Dhruv242003/GRF_Shoe/Images/System Design.png

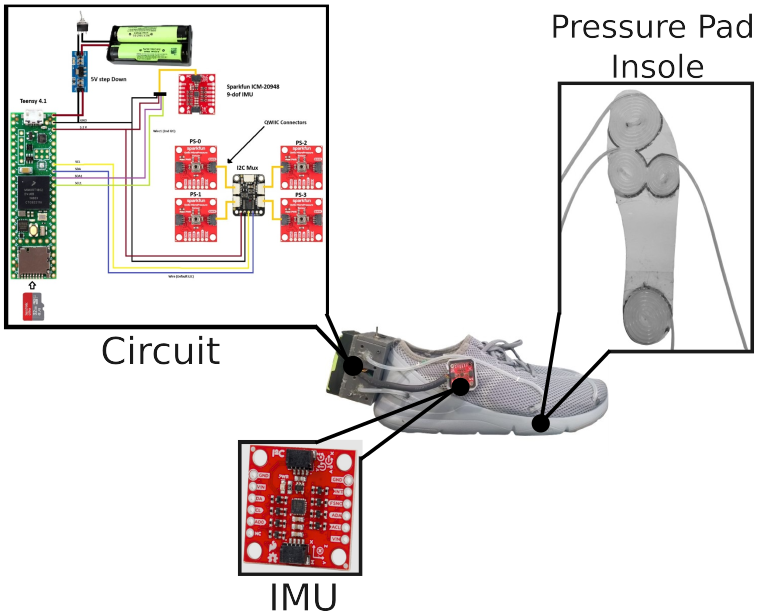
Images/System Design.png
