Dhruv242003/GRF_Shoe/Images/I2C_mux.jpg

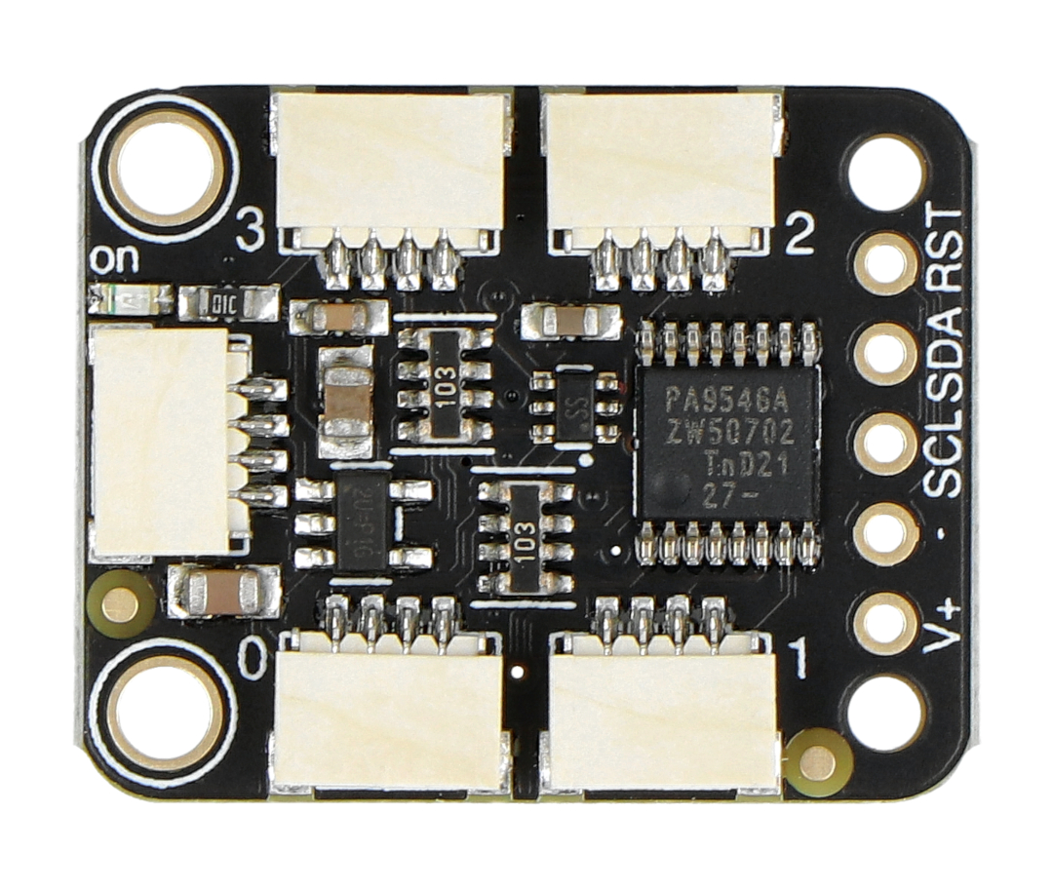
Images/I2C_mux.jpg
