Dhruv242003/GRF_Shoe/Presentation/Smart Shoes.pptx

## Smart Shoes

- HCR Lab Meeting

- Dhruv Thakkar

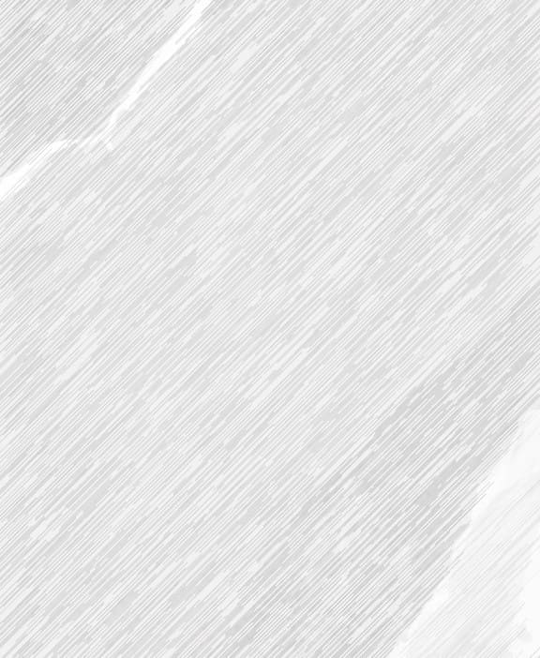
[picture p3: figure]
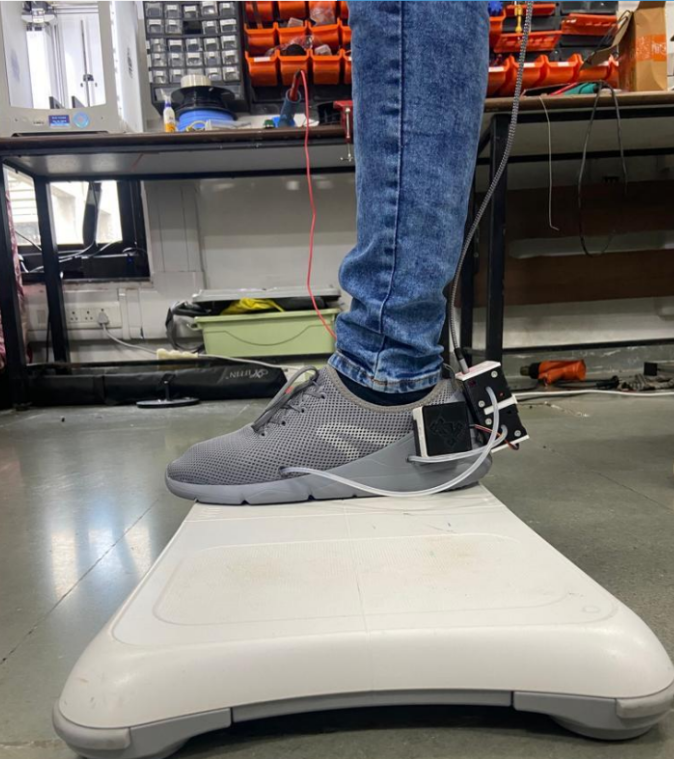
[picture p4: figure]

## Progress Till Now

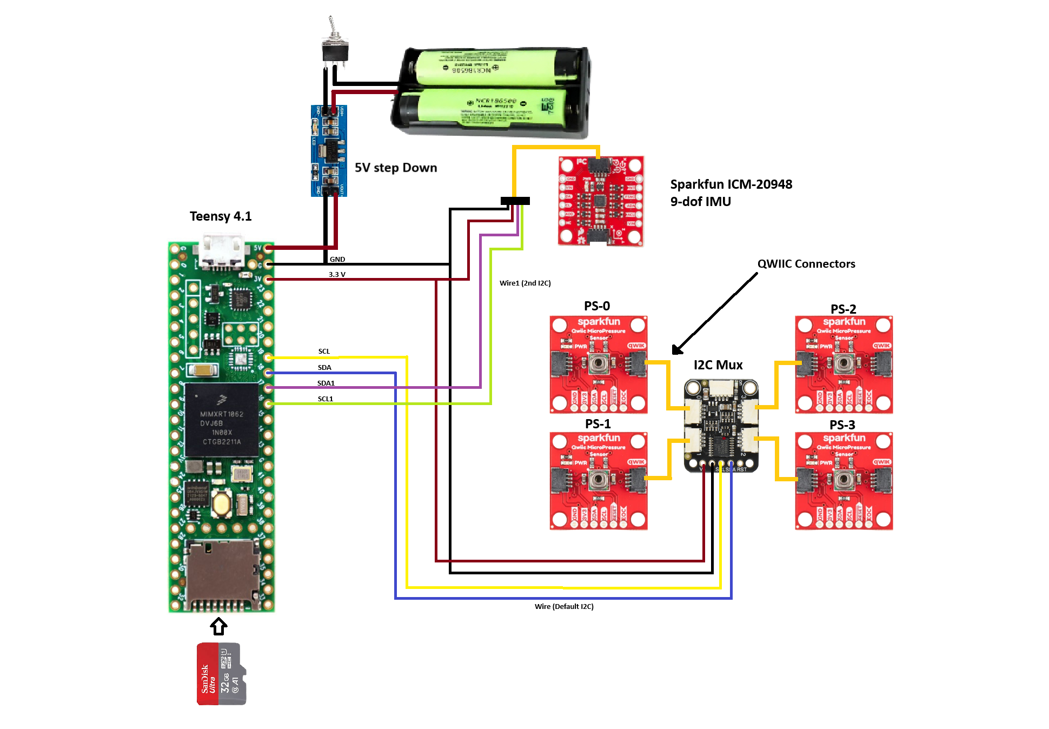
[picture p5: figure]

Circuit Diagram

## CAD

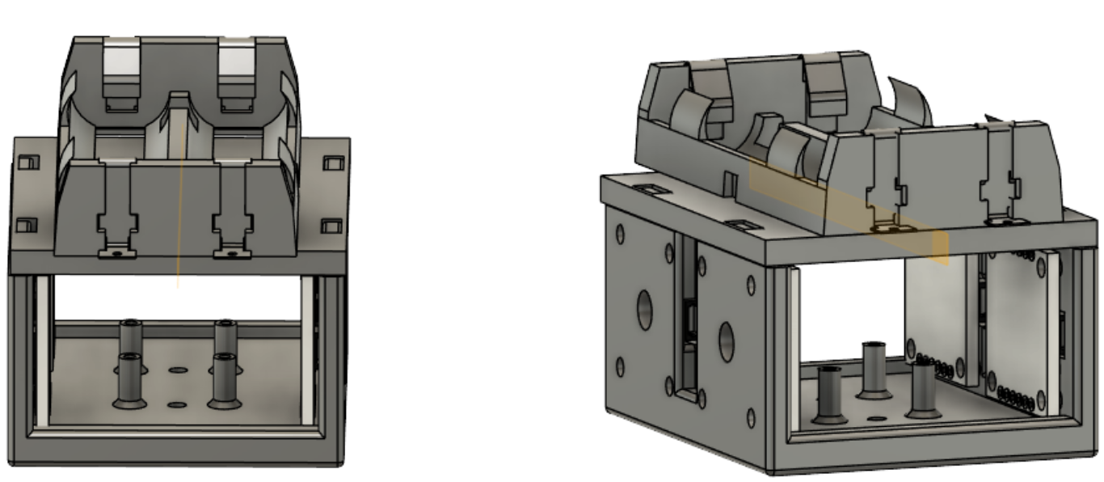
[picture p6: figure]

## Slide 4
