Dhruv242003/GRF_Shoe/Circuit/Dual_i2c.png

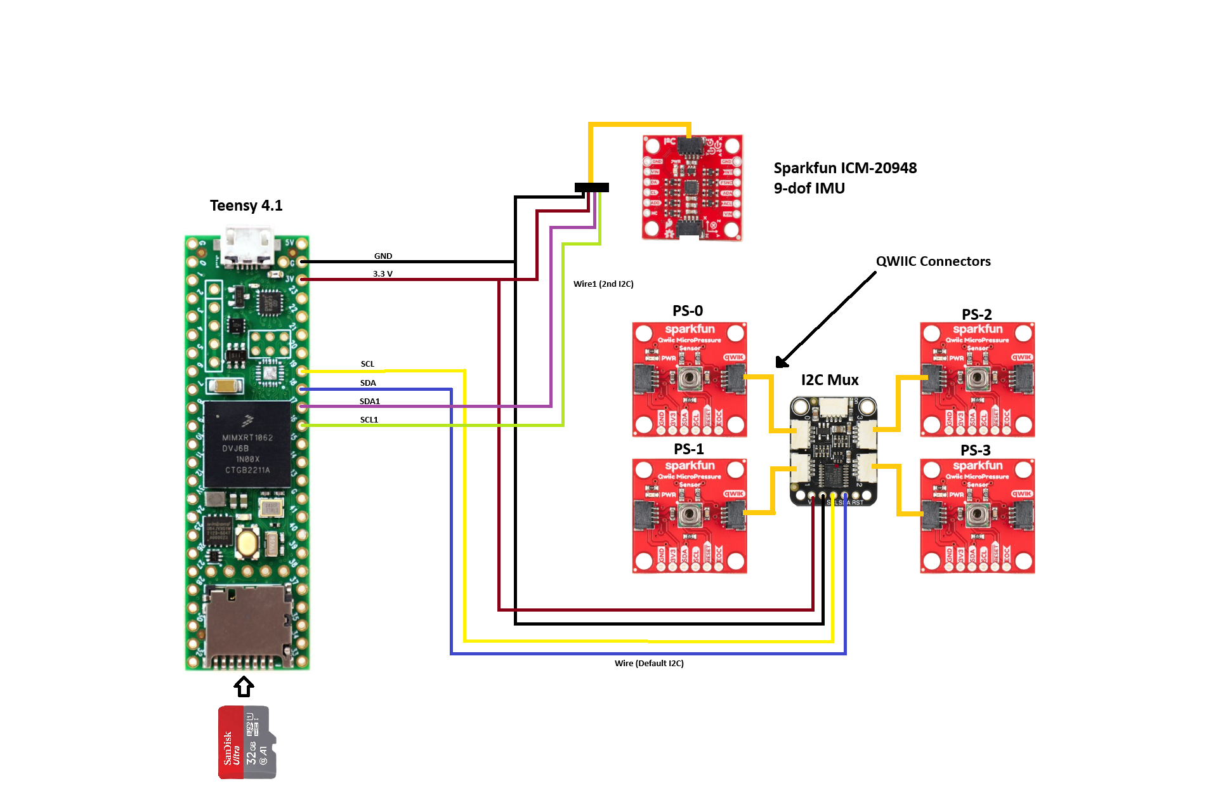
Circuit/Dual_i2c.png
