Dhruv242003/GRF_Shoe/Images/All_models_grid.png

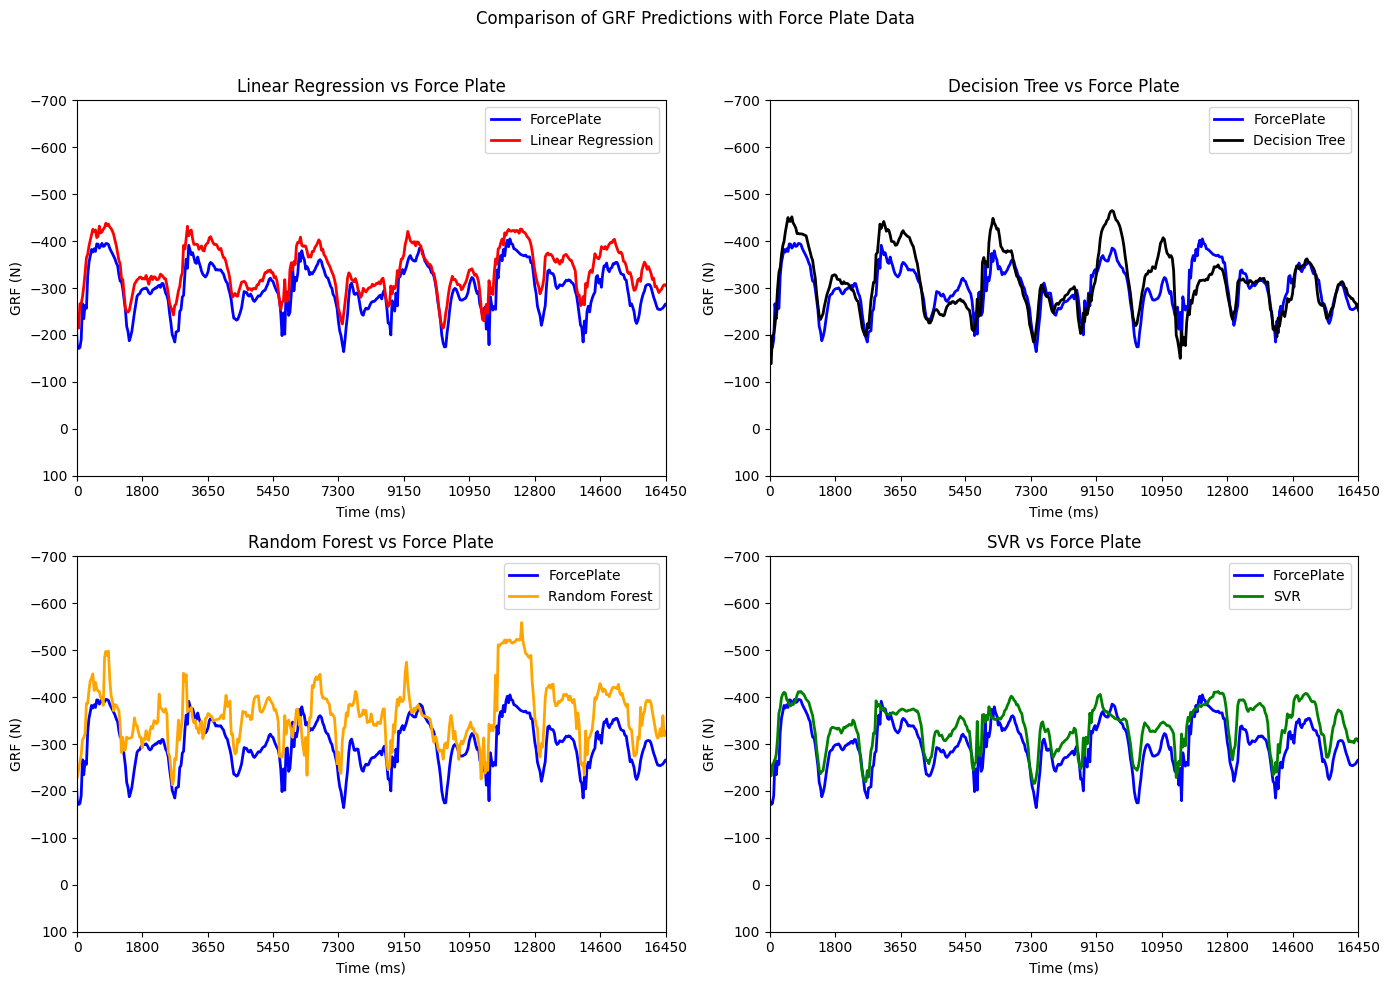
Images/All_models_grid.png
