Dhruv242003/GRF_Shoe/Images/All_models_plot.png

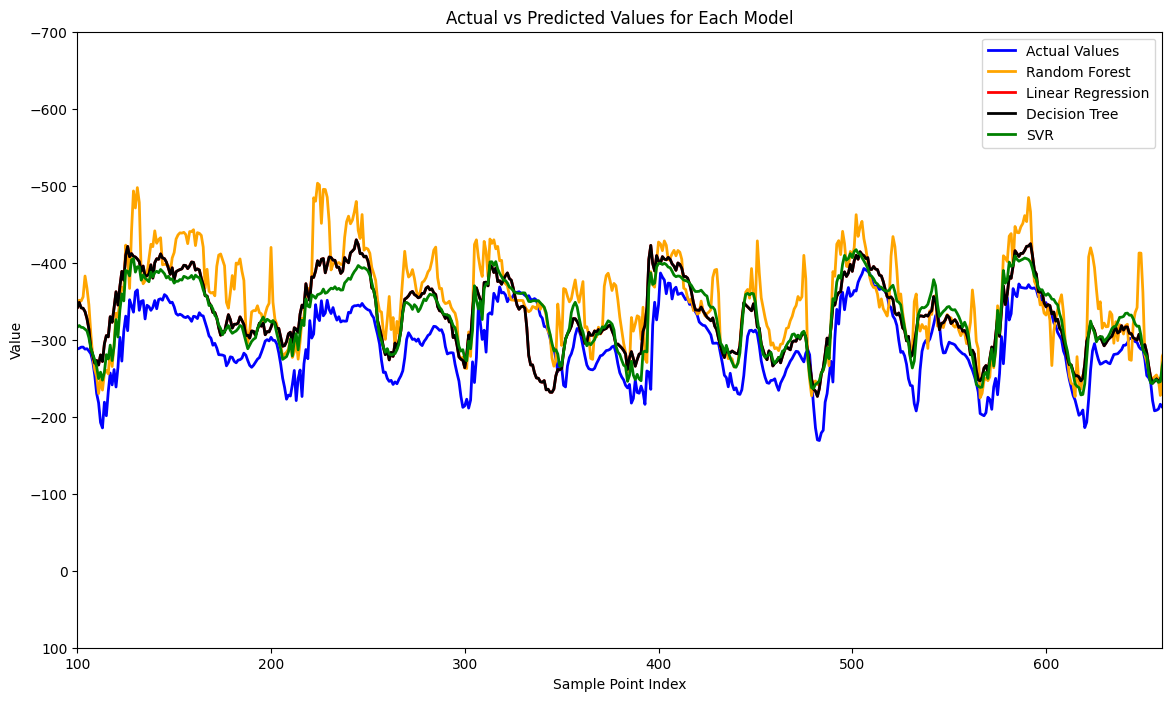
Images/All_models_plot.png
