Dhruv242003/GRF_Shoe/Images/DL_output.png

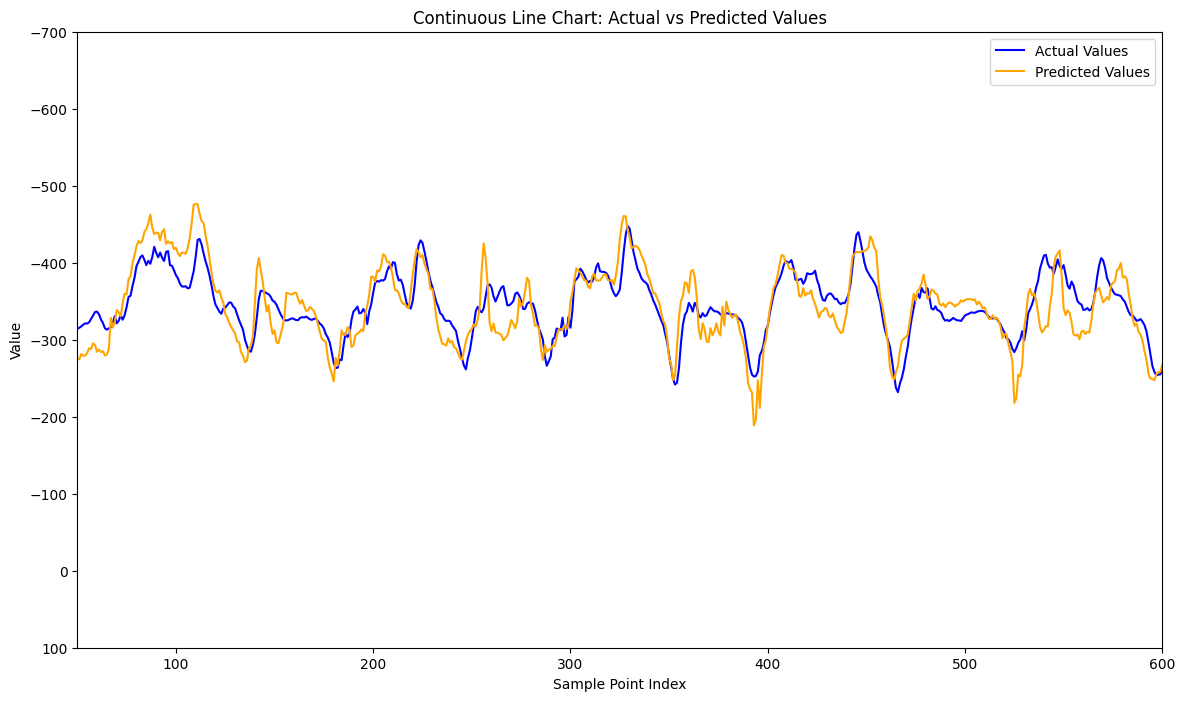
Images/DL_output.png
