Dhruv242003/GRF_Shoe/Images/download.png

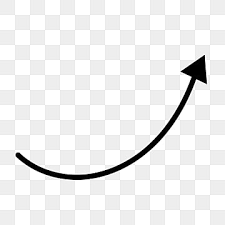
Images/download.png
