Dhruv242003/GRF_Shoe/Images/Flat_foot.jpg

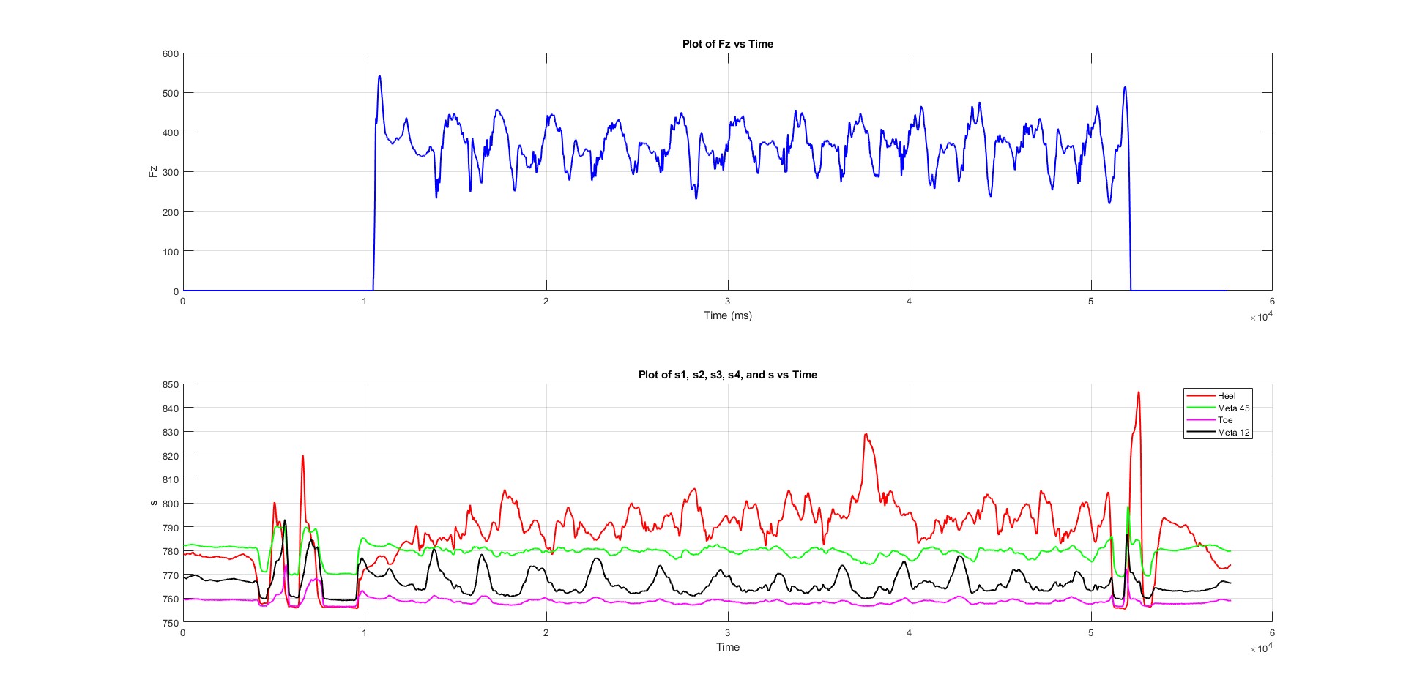
Images/Flat_foot.jpg
