Dhruv242003/GRF_Shoe/Images/Flowchart1.png

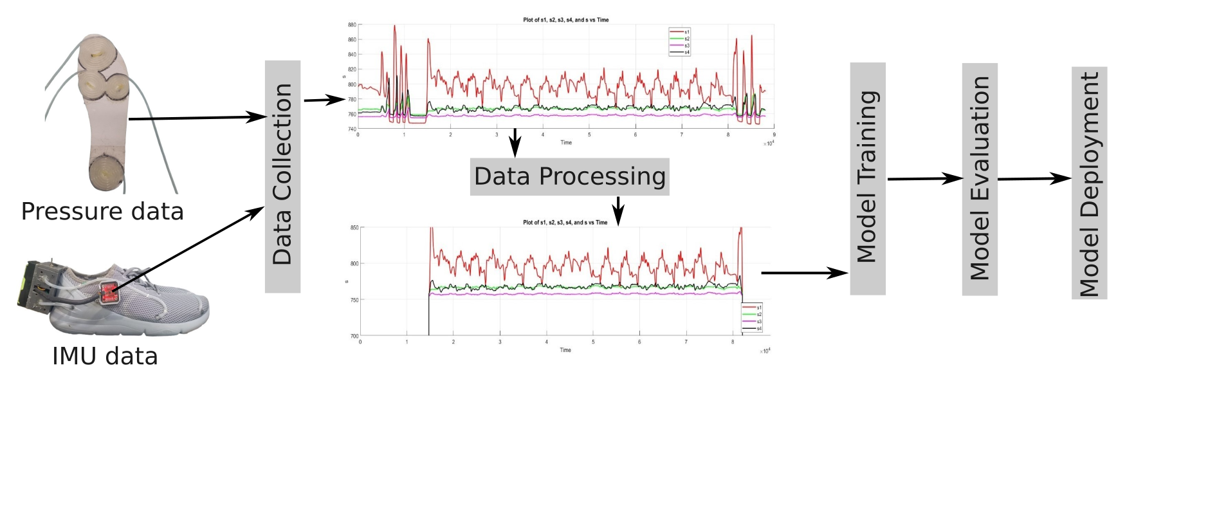
Images/Flowchart1.png
