Dhruv242003/GRF_Shoe/Images/LinearRegression_plot.png

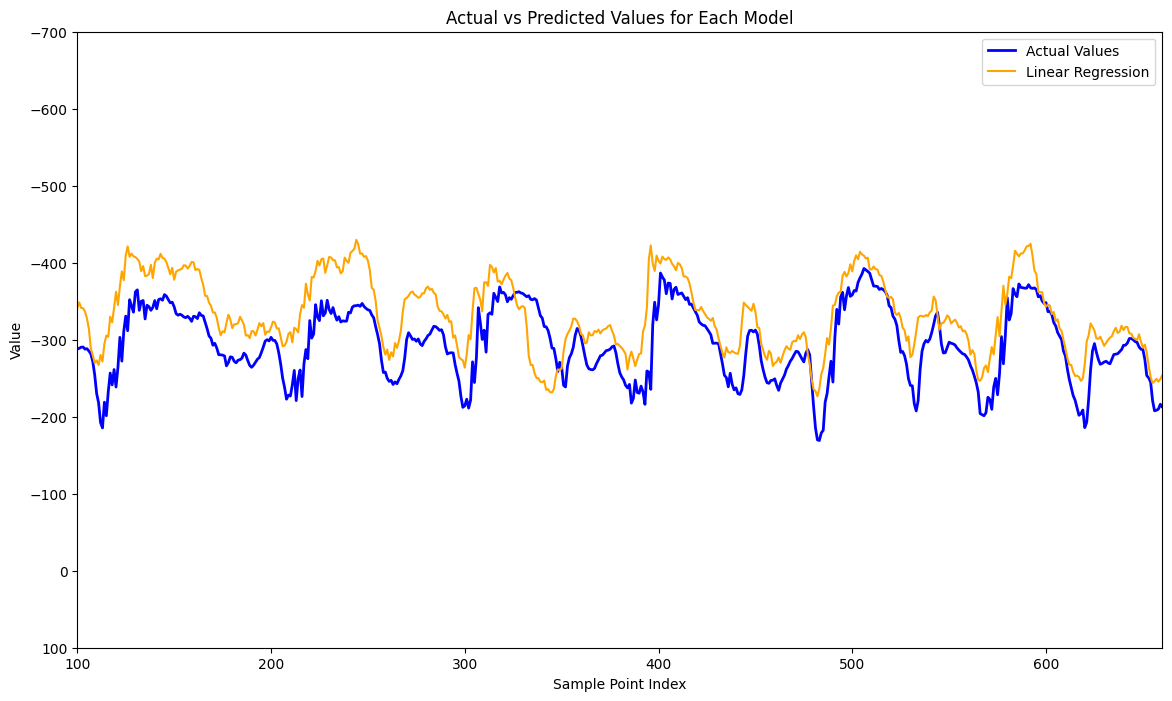
Images/LinearRegression_plot.png
