Dhruv242003/GRF_Shoe/Images/LossCurve.png

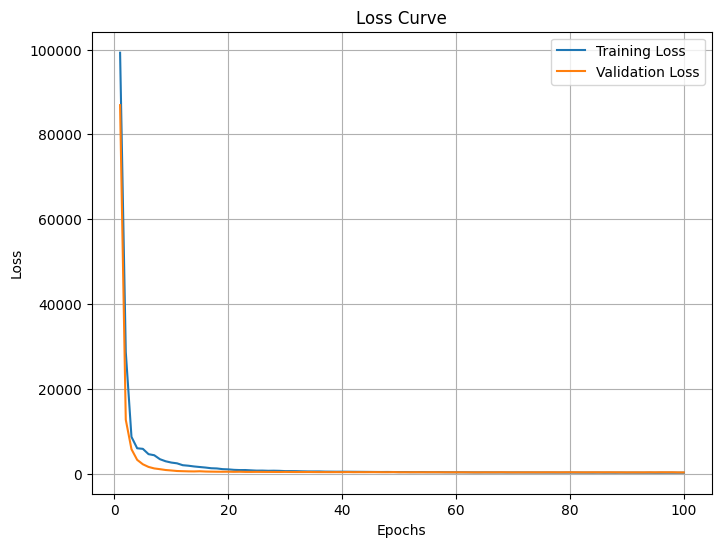
Images/LossCurve.png
