Dhruv242003/GRF_Shoe/Images/Model Architecture.png

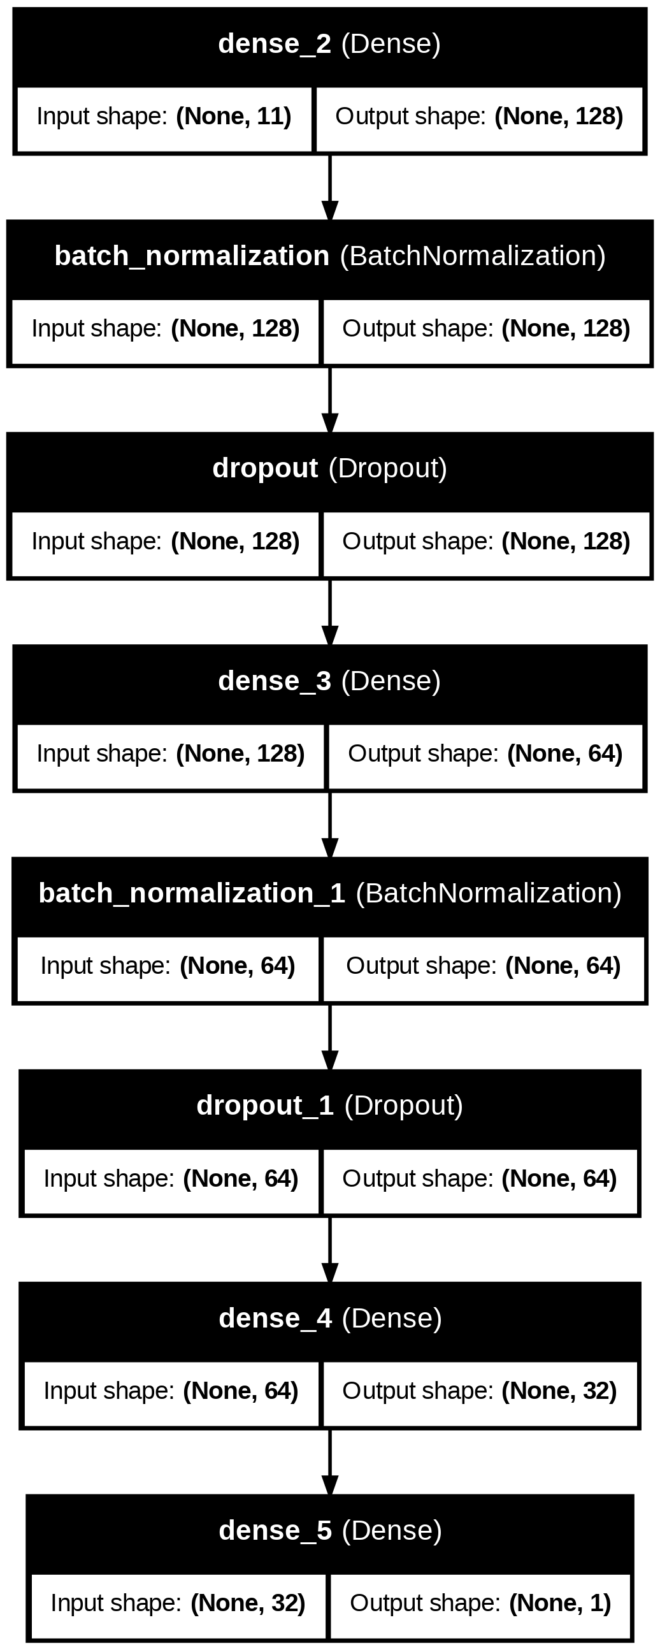
Images/Model Architecture.png
