Dhruv242003/GRF_Shoe/Images/Normal_foot.jpg

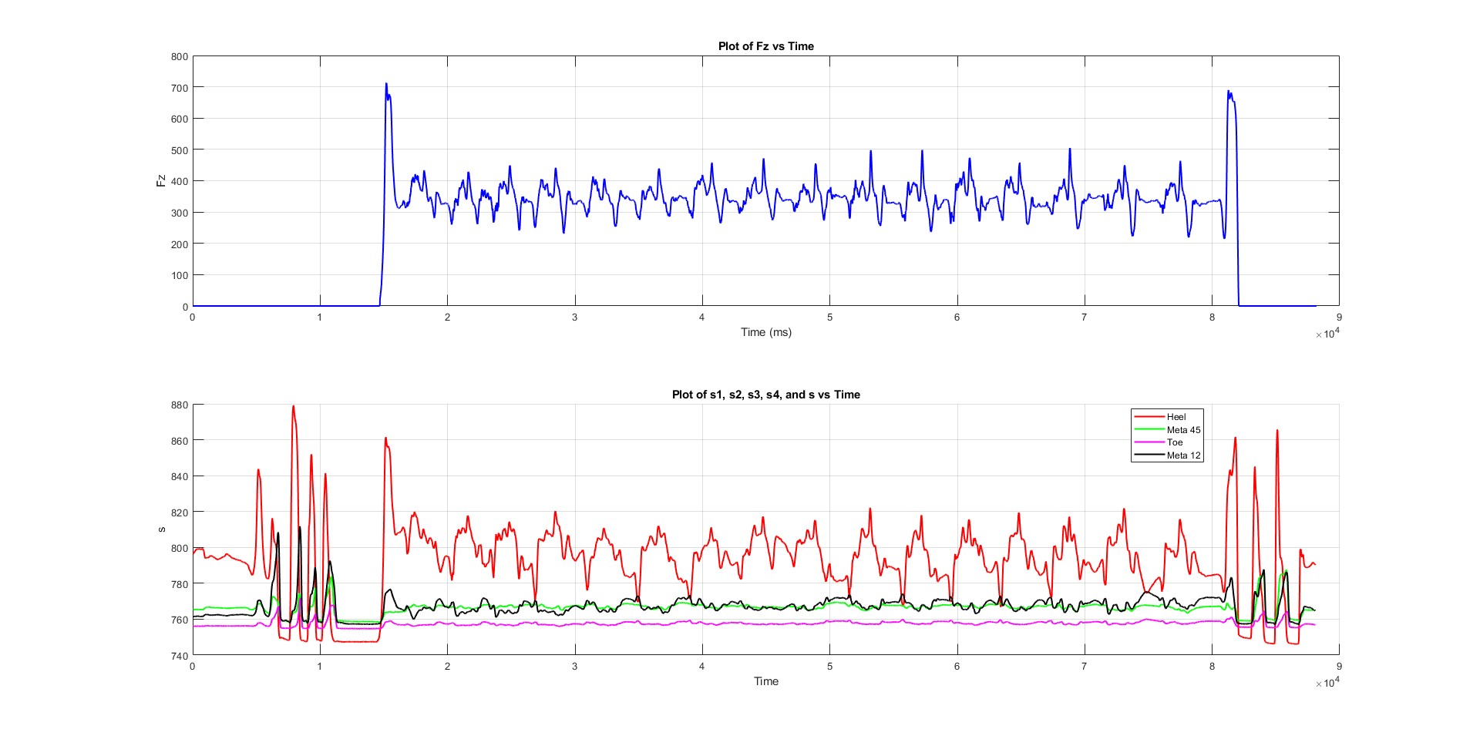
Images/Normal_foot.jpg
