Dhruv242003/GRF_Shoe/Images/oneSquat.png

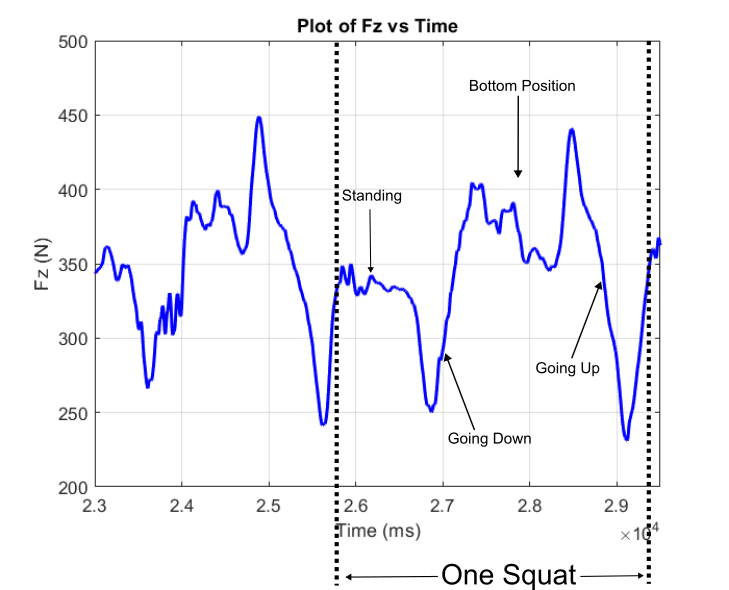
Images/oneSquat.png
