Dhruv242003/GRF_Shoe/Images/output.png

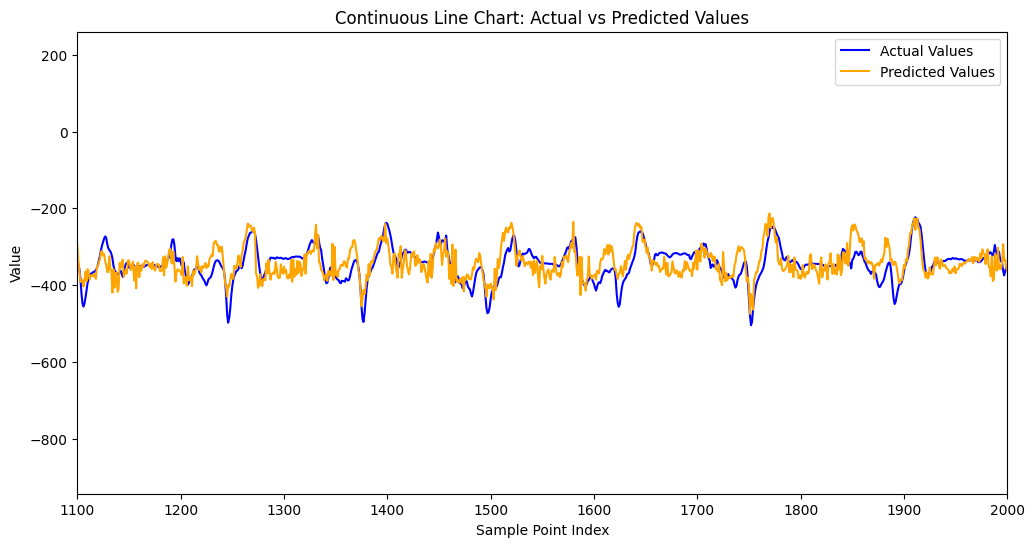
Images/output.png
