Dhruv242003/GRF_Shoe/Images/Pneumatic_connections.png

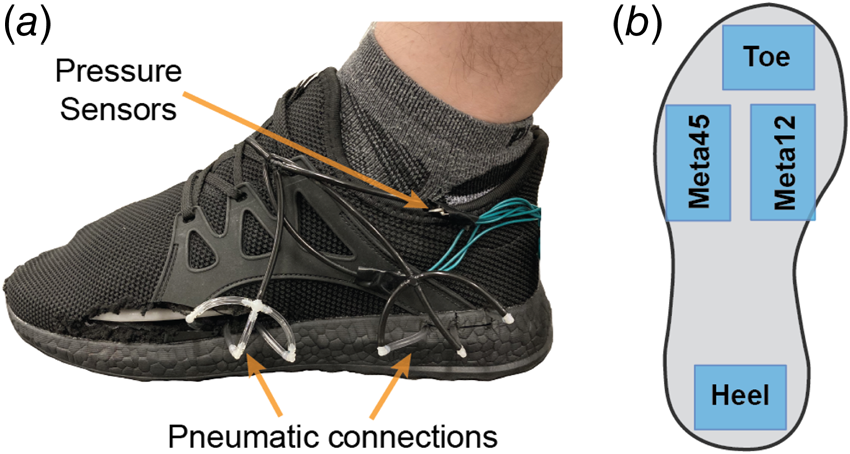
Images/Pneumatic_connections.png
