Dhruv242003/GRF_Shoe/Images/pressure_sensor-removebg-preview.png

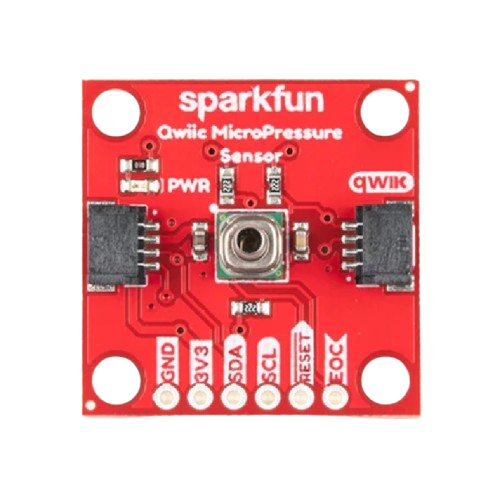
Images/pressure_sensor-removebg-preview.png
