Dhruv242003/GRF_Shoe/Images/Regression Output.png

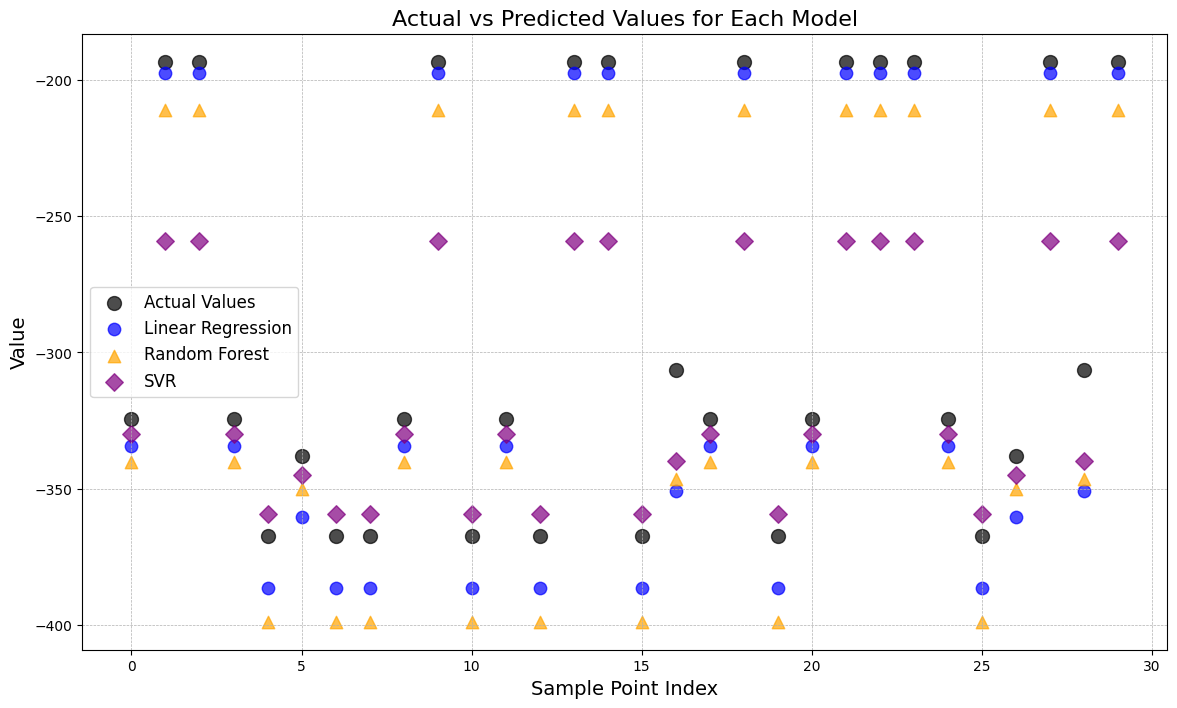
Images/Regression Output.png
