Dhruv242003/GRF_Shoe/Images/rt_LR.png

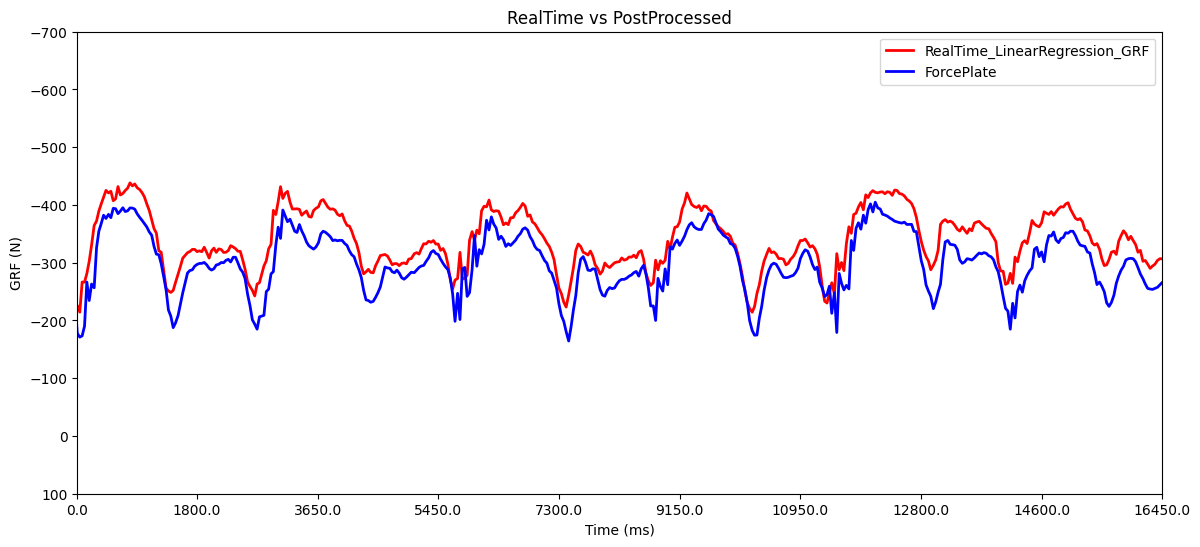
Images/rt_LR.png
