Dhruv242003/GRF_Shoe/Images/rt_vs_laptop_sameMaths.png

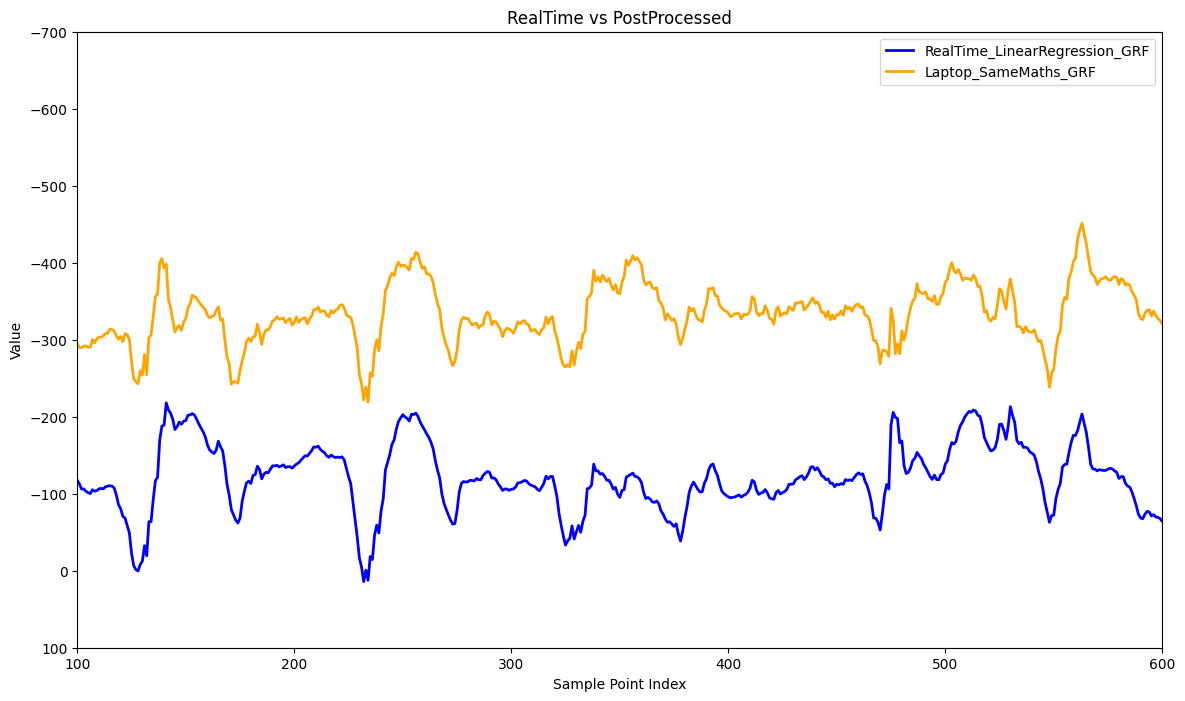
Images/rt_vs_laptop_sameMaths.png
