Dhruv242003/GRF_Shoe/Images/rt_vs_postProcessing.png

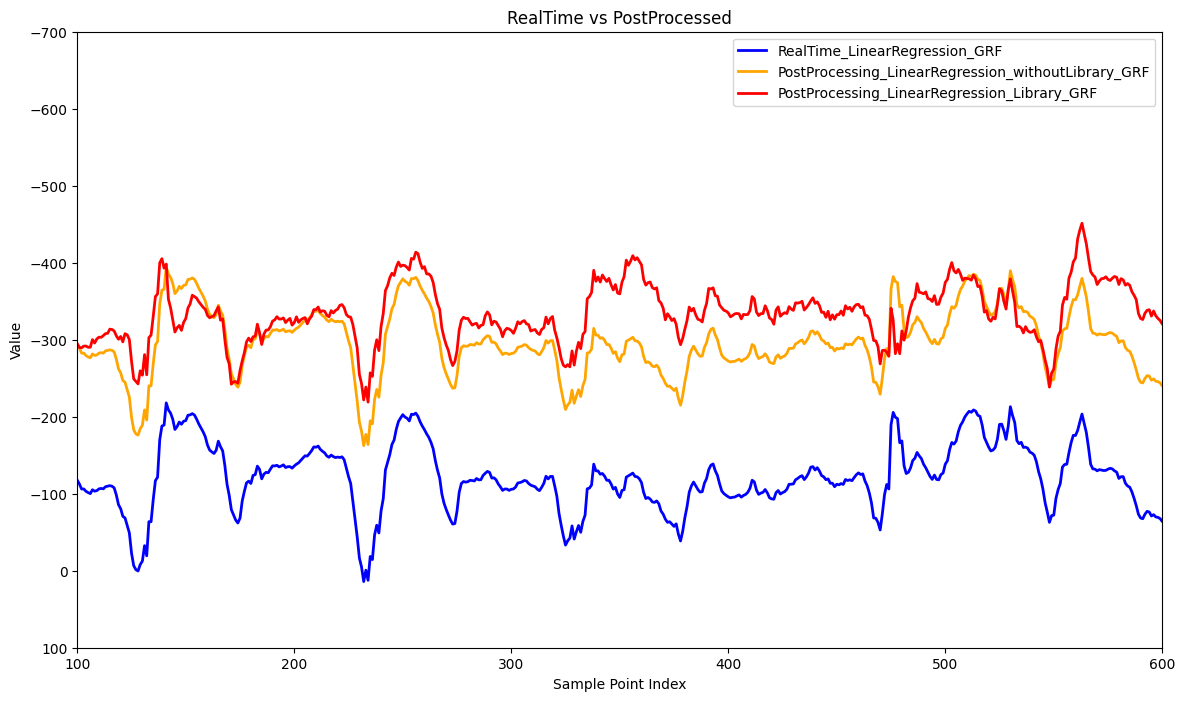
Images/rt_vs_postProcessing.png
