Dhruv242003/GRF_Shoe/Images/Screenshot 2024-08-16 115110.png

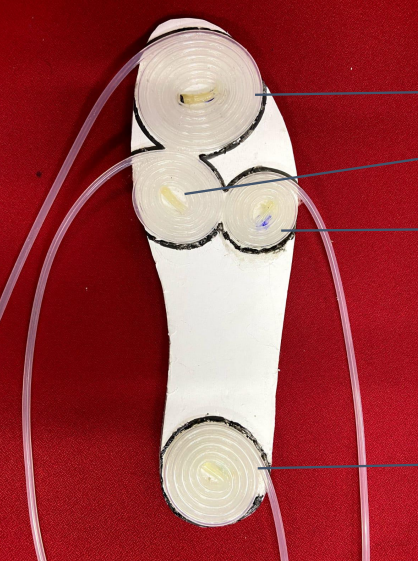
Images/Screenshot 2024-08-16 115110.png
