Dhruv242003/GRF_Shoe/Images/Screenshot 2024-09-20 162421.png

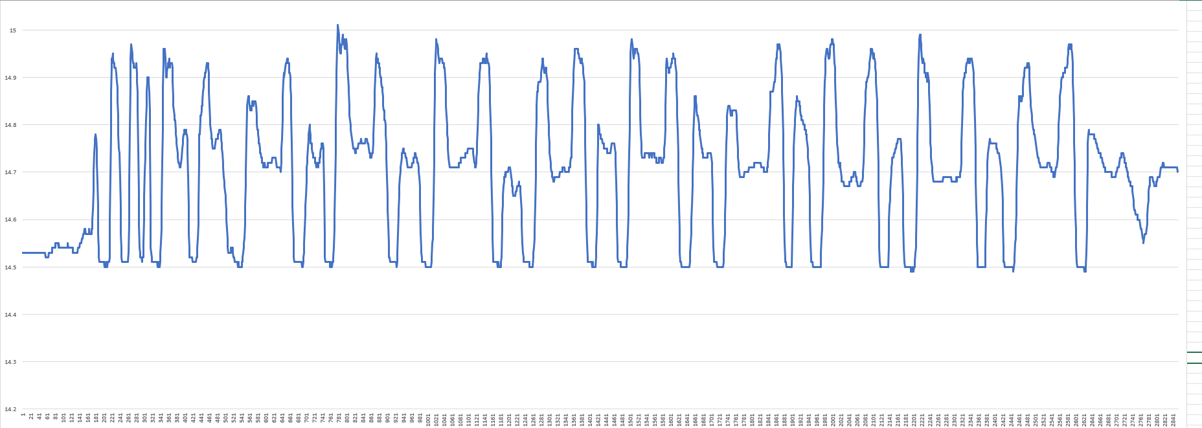
Images/Screenshot 2024-09-20 162421.png
