Dhruv242003/GRF_Shoe/Images/Screenshot 2024-10-01 151310.png

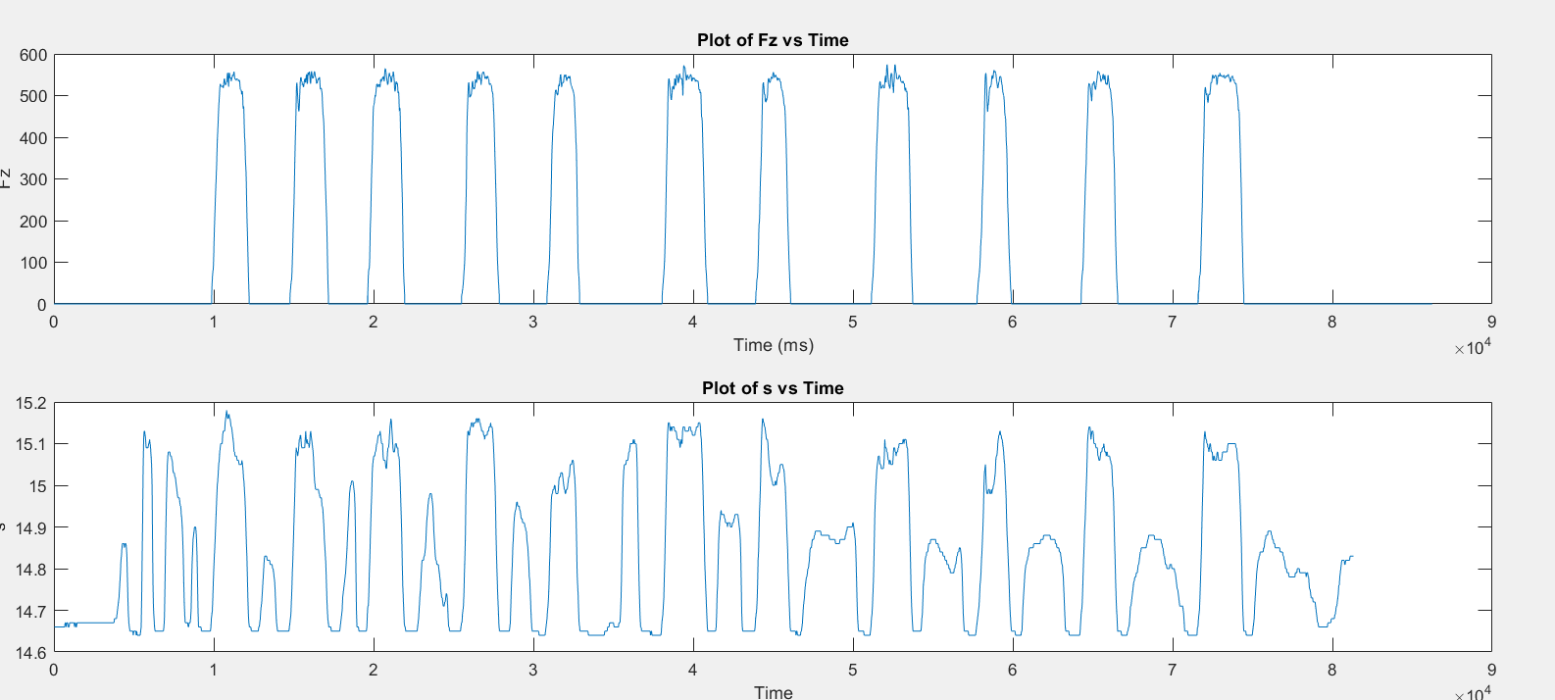
Images/Screenshot 2024-10-01 151310.png
