Dhruv242003/GRF_Shoe/Images/Screenshot 2024-10-01 161214.png

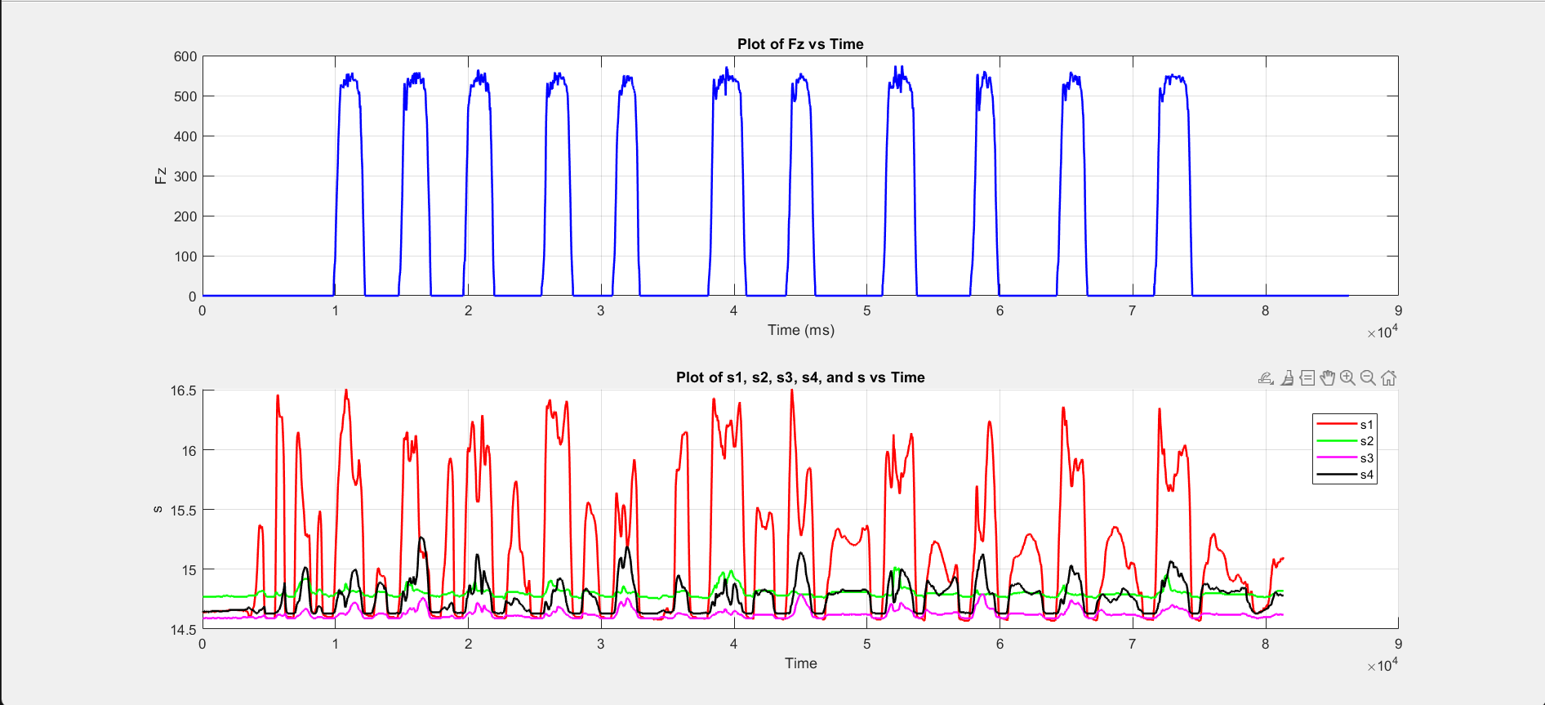
Images/Screenshot 2024-10-01 161214.png
