Dhruv242003/GRF_Shoe/Images/Screenshot 2024-10-01 162554.png

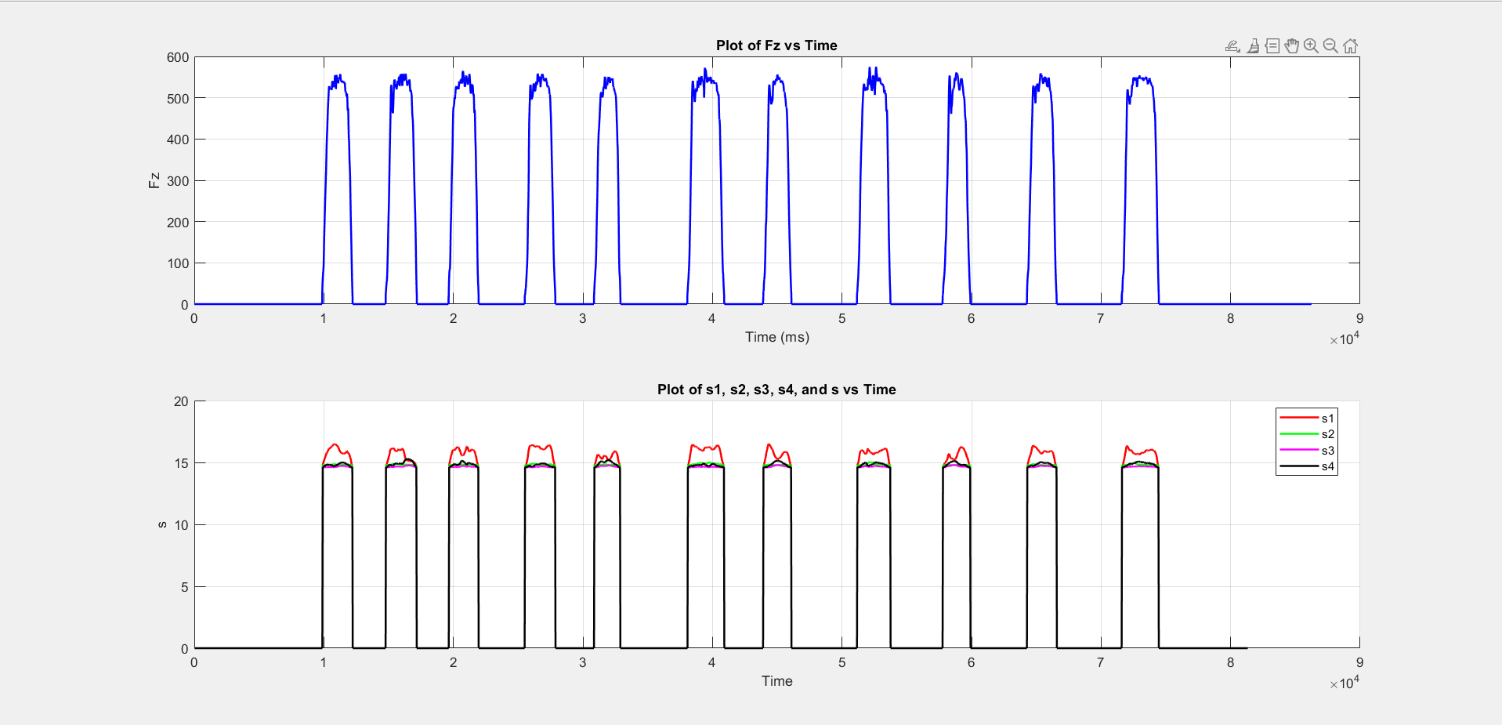
Images/Screenshot 2024-10-01 162554.png
