Dhruv242003/GRF_Shoe/Images/SD card.jpg

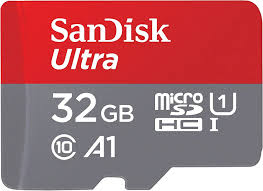
Images/SD card.jpg
