Dhruv242003/GRF_Shoe/Images/sitToStand_DL.png

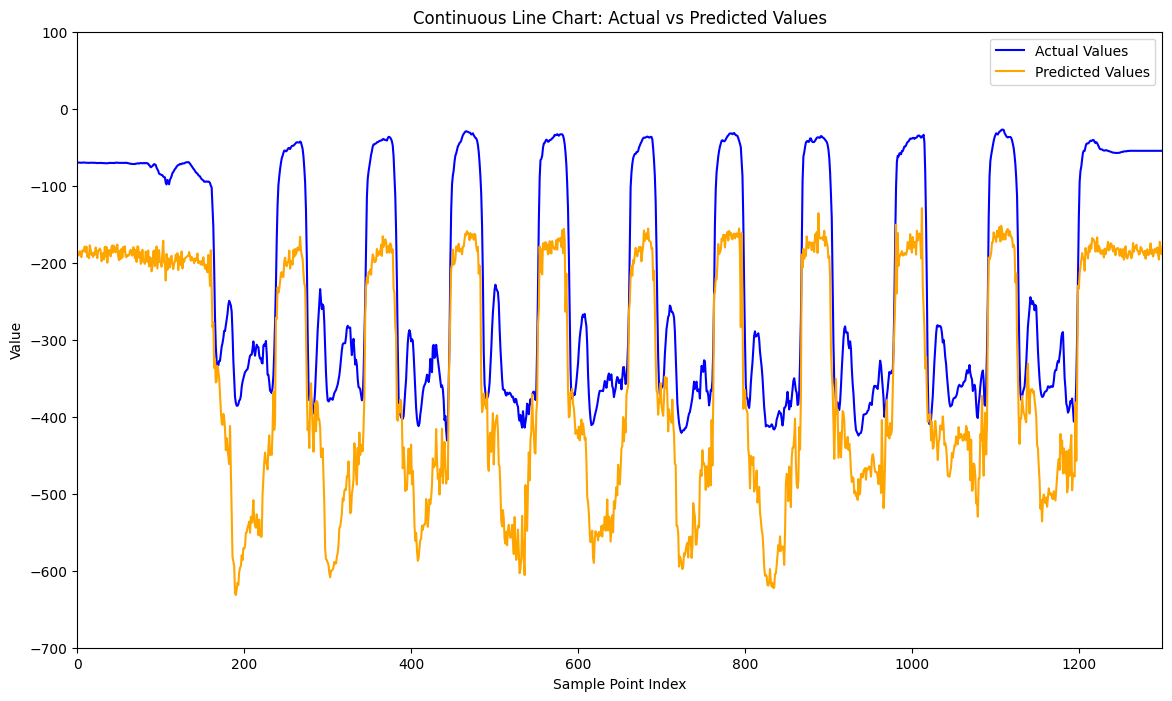
Images/sitToStand_DL.png
