Dhruv242003/GRF_Shoe/Images/sitToStand_randomForest.png

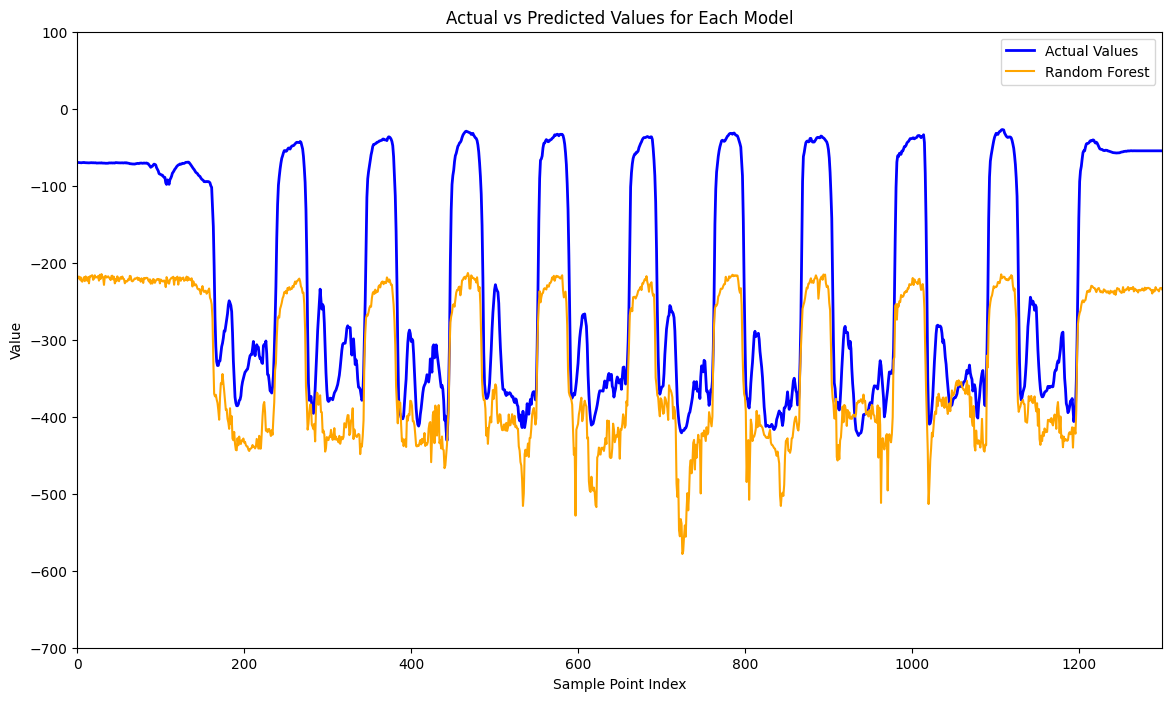
Images/sitToStand_randomForest.png
