Dhruv242003/GRF_Shoe/Images/sitToStand_twoShoes.jpg

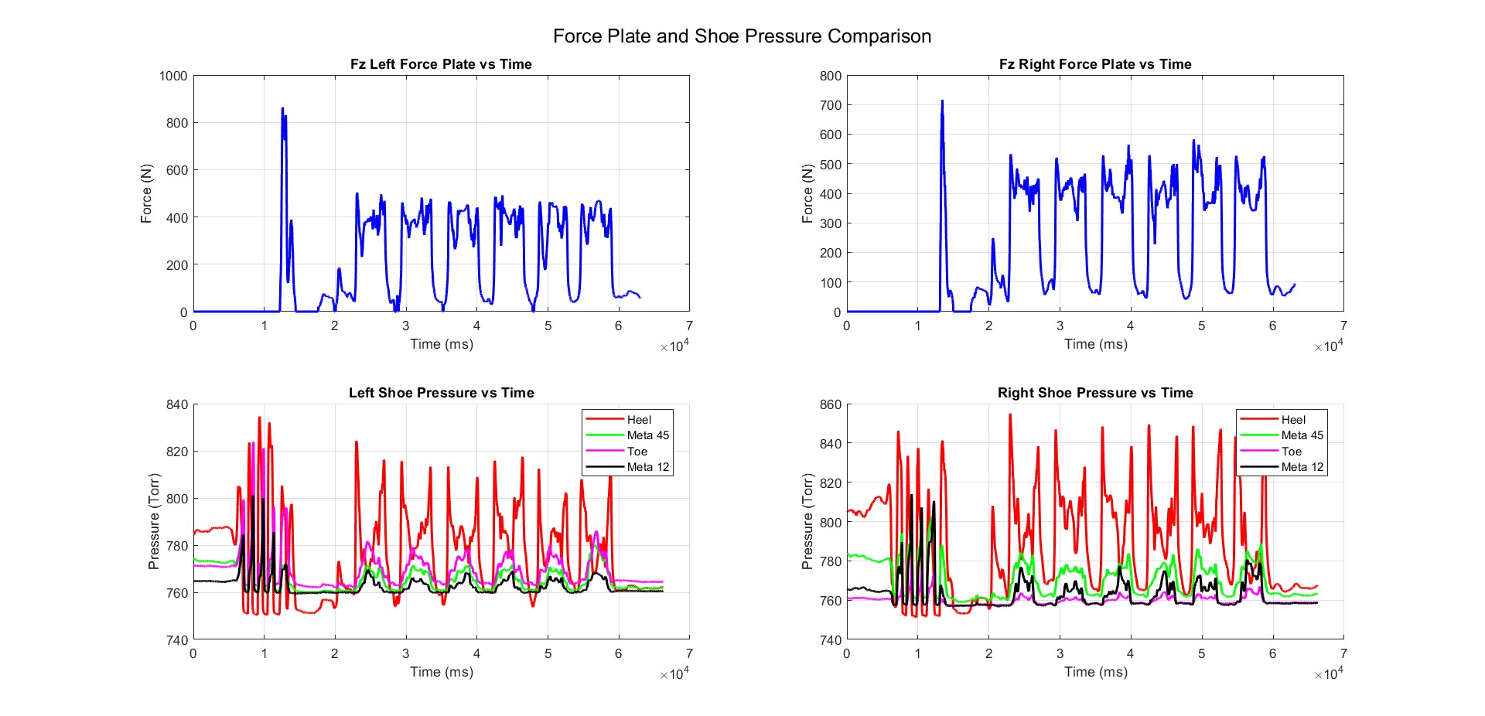
Images/sitToStand_twoShoes.jpg
