Dhruv242003/GRF_Shoe/Images/Sparkfun_ICM-20948-removebg-preview.png

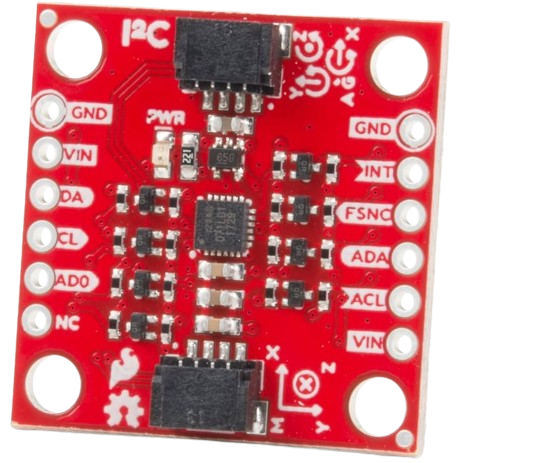
Images/Sparkfun_ICM-20948-removebg-preview.png
