Dhruv242003/GRF_Shoe/Images/sqautting_oneCycle.png

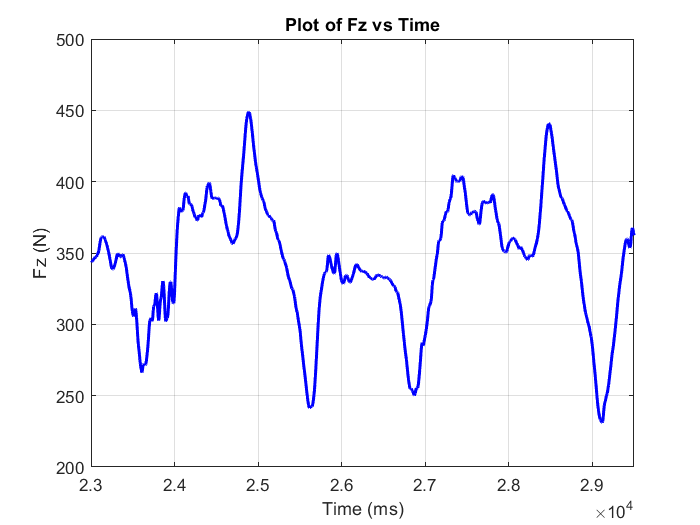
Images/sqautting_oneCycle.png
