Dhruv242003/GRF_Shoe/Images/squatting processed.jpg

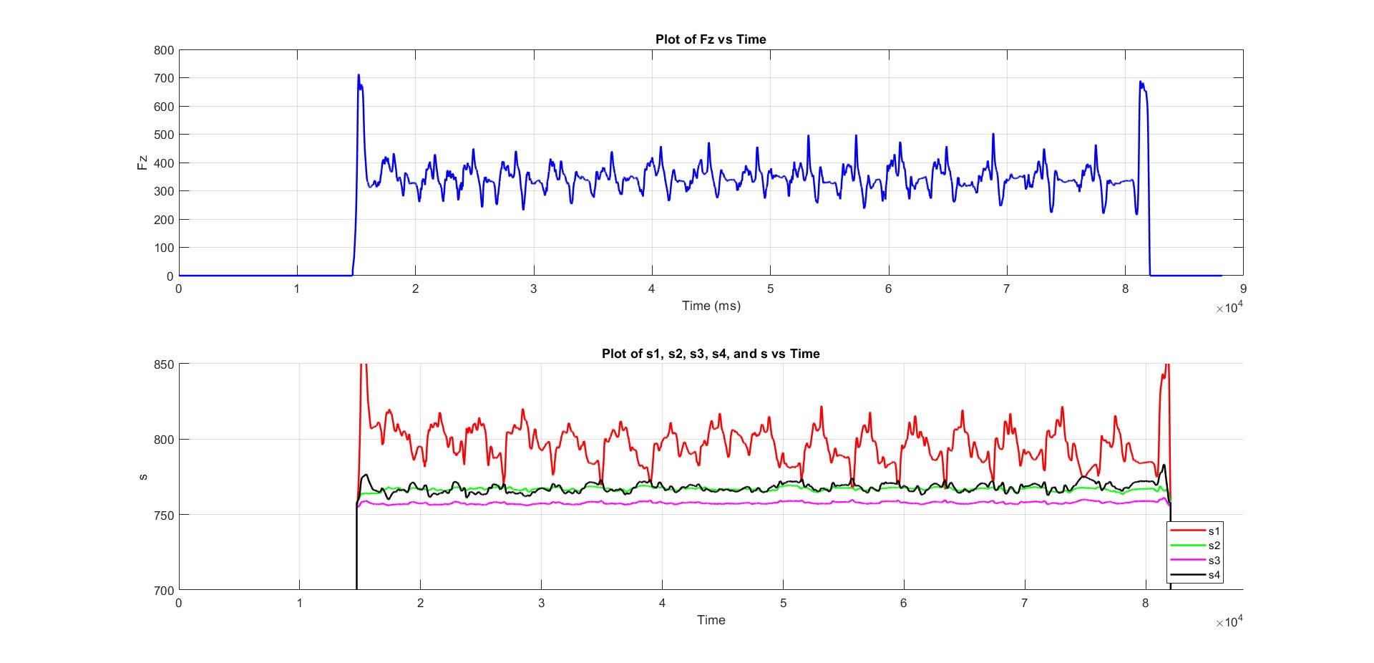
Images/squatting processed.jpg
