Dhruv242003/GRF_Shoe/Images/squatting uprocessed.jpg

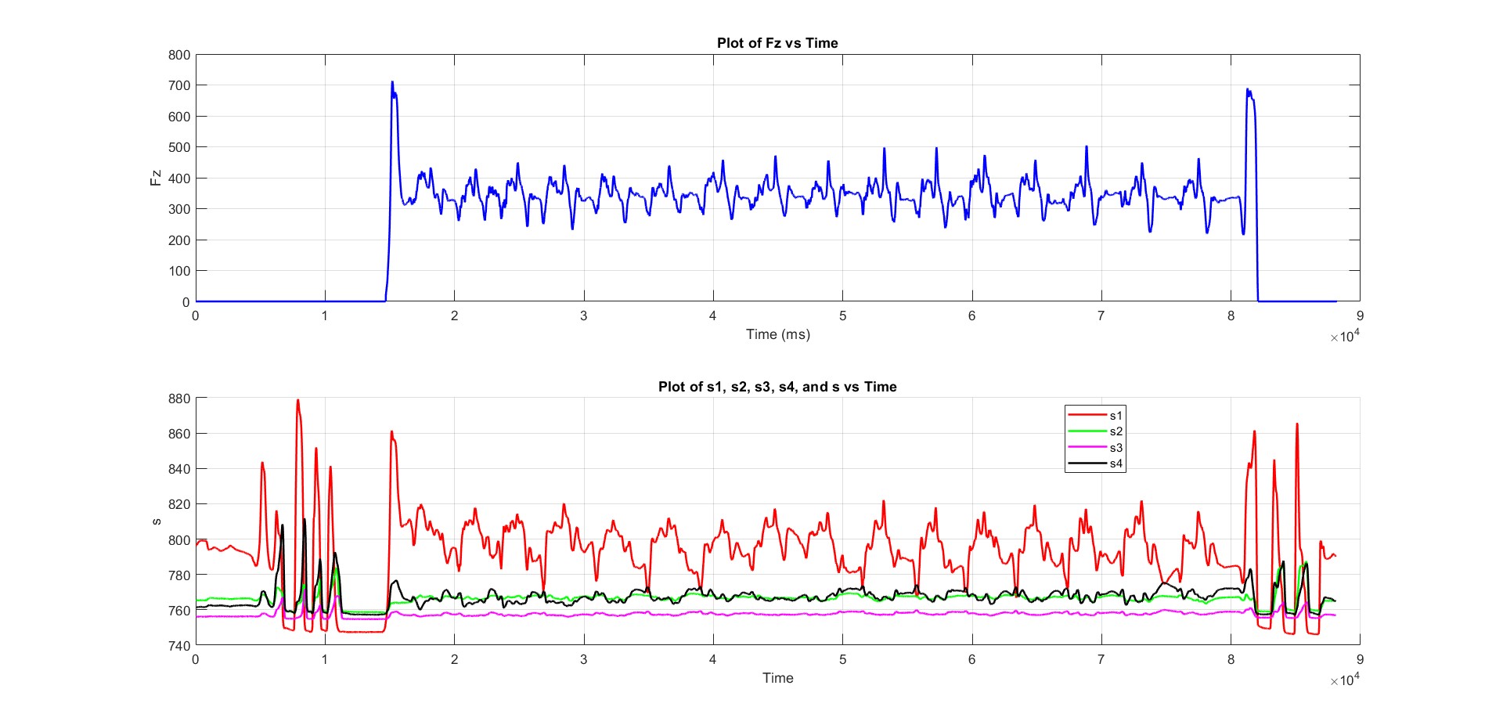
Images/squatting uprocessed.jpg
