Dhruv242003/GRF_Shoe/Images/Squatting.jpg

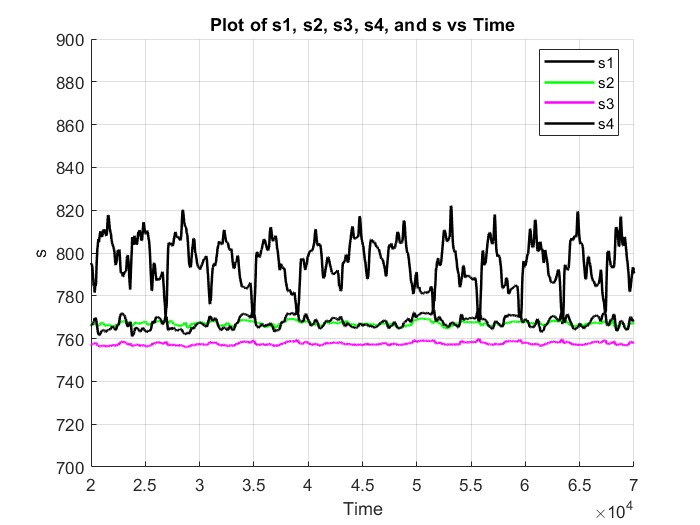
Images/Squatting.jpg
