Dhruv242003/GRF_Shoe/Images/standing_data_two_shoes.jpg

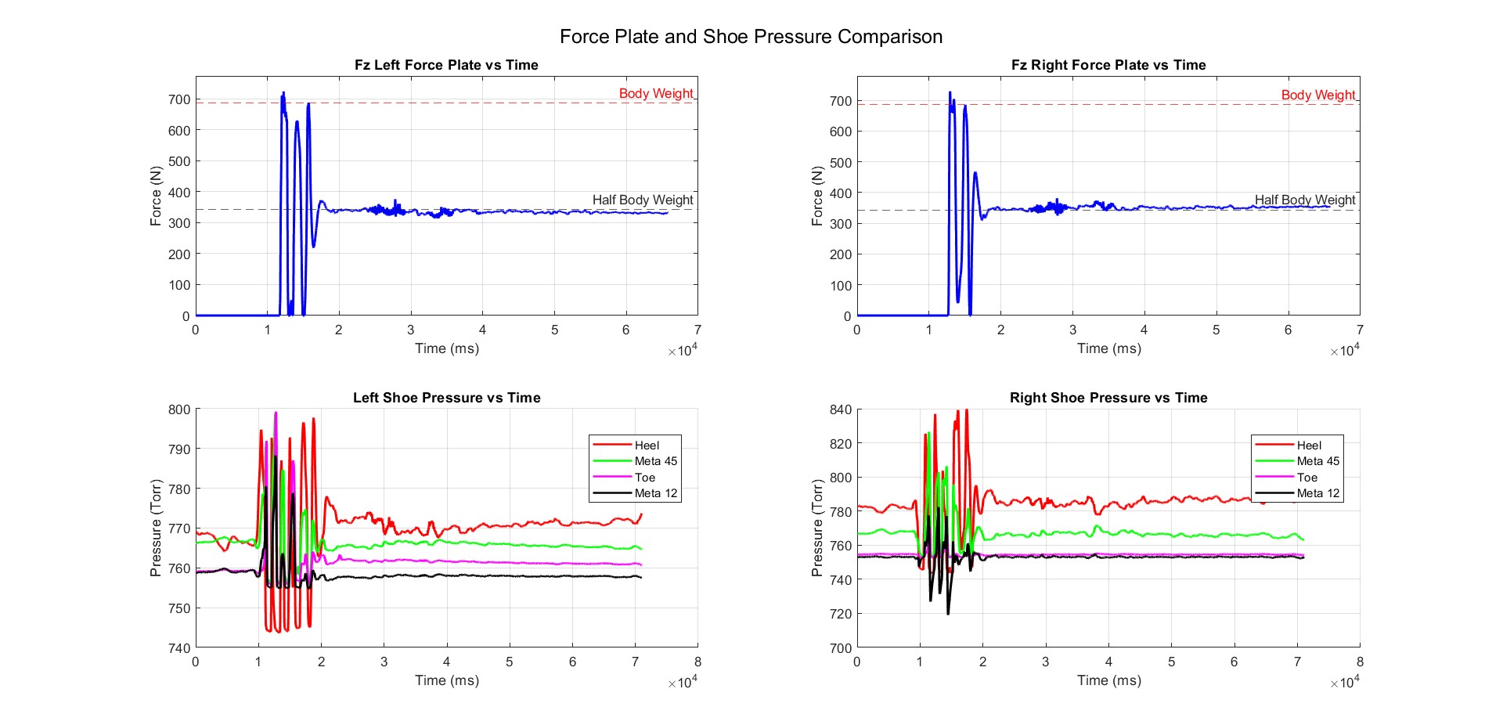
Images/standing_data_two_shoes.jpg
