Dhruv242003/GRF_Shoe/Images/Sync.jpg

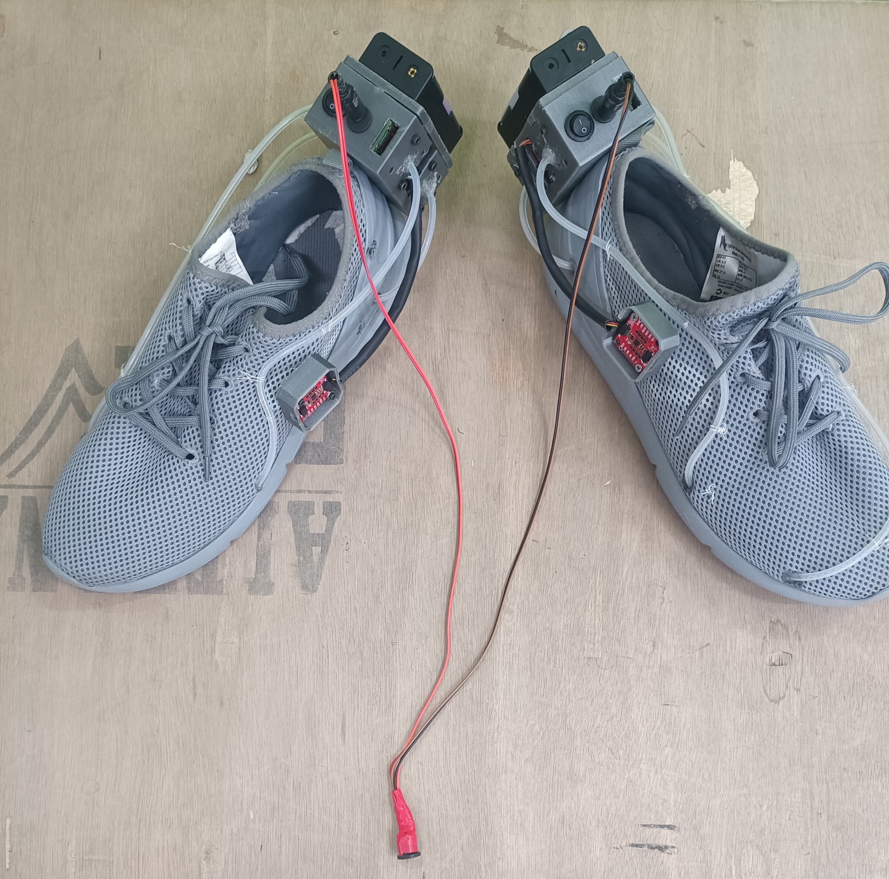
Images/Sync.jpg
