Dhruv242003/GRF_Shoe/Images/Two Shoes.jpg

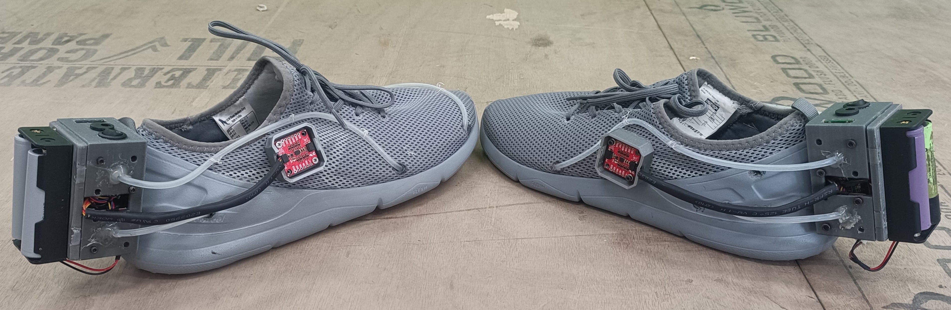
Images/Two Shoes.jpg
