Dhruv242003/GRF_Shoe/Images/TwoShoe_restValues.jpg

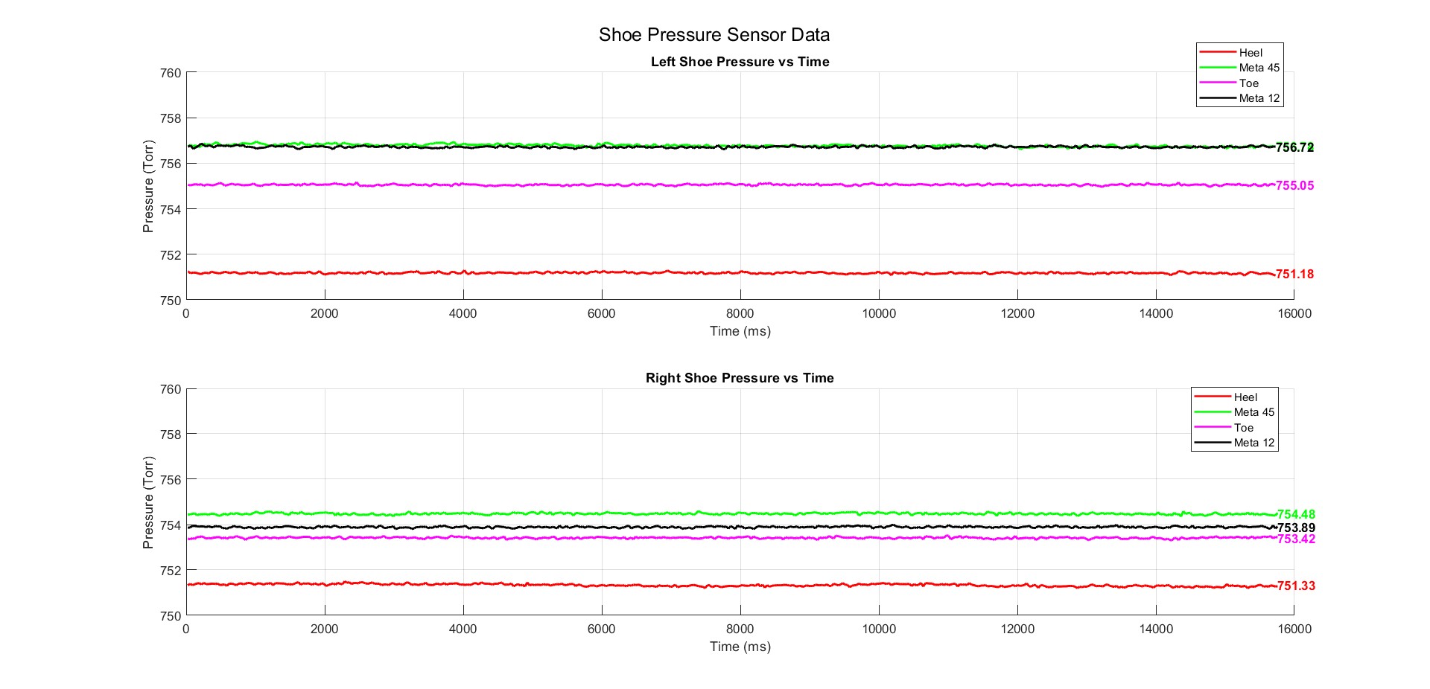
Images/TwoShoe_restValues.jpg
