Dhruv242003/GRF_Shoe/Images/WhatsApp Image 2024-09-11 at 11.49.34_7fd7d82a.jpg

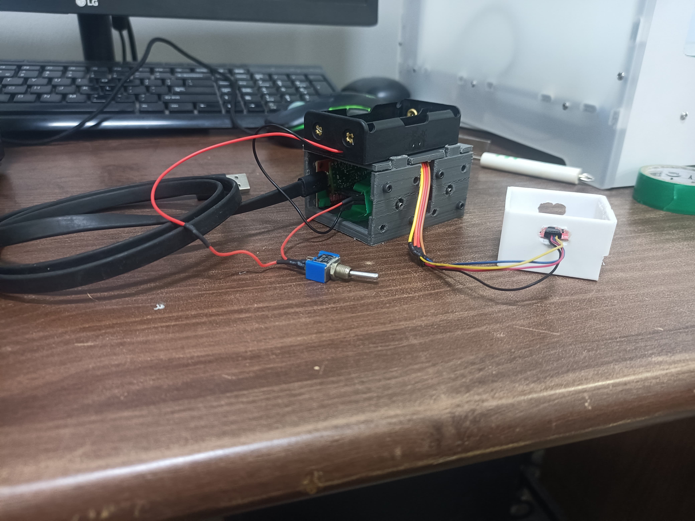
Images/WhatsApp Image 2024-09-11 at 11.49.34_7fd7d82a.jpg
