Dhruv242003/GRF_Shoe/Images/WhatsApp Image 2024-09-11 at 11.49.35_b6d47014.jpg

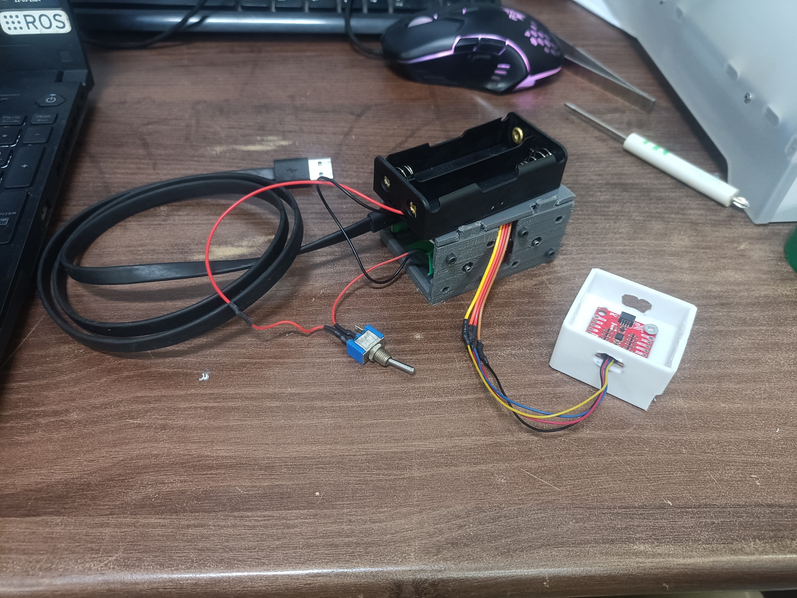
Images/WhatsApp Image 2024-09-11 at 11.49.35_b6d47014.jpg
