Dhruv242003/GRF_Shoe/Images/WhatsApp Image 2024-10-03 at 14.58.49_7d13ea89.jpg

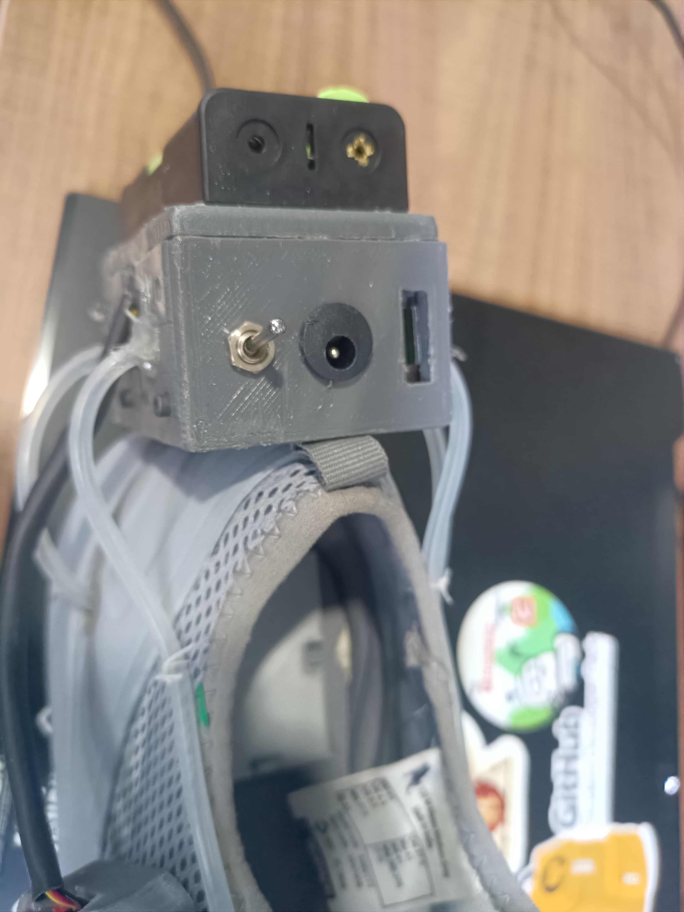
Images/WhatsApp Image 2024-10-03 at 14.58.49_7d13ea89.jpg
