Dhruv242003/GRF_Shoe/Images/WhatsApp Image 2024-10-03 at 14.58.50_570be8ac.jpg

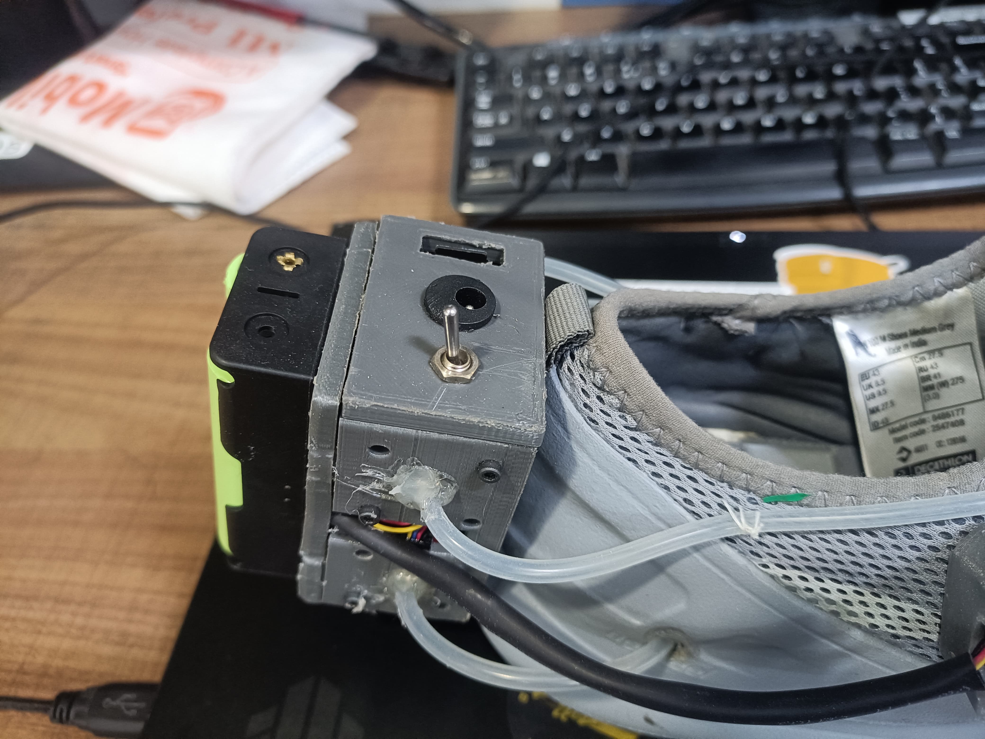
Images/WhatsApp Image 2024-10-03 at 14.58.50_570be8ac.jpg
