Dhruv242003/GRF_Shoe/Images/WhatsApp Image 2024-10-03 at 14.58.51_cc8e7d46.jpg

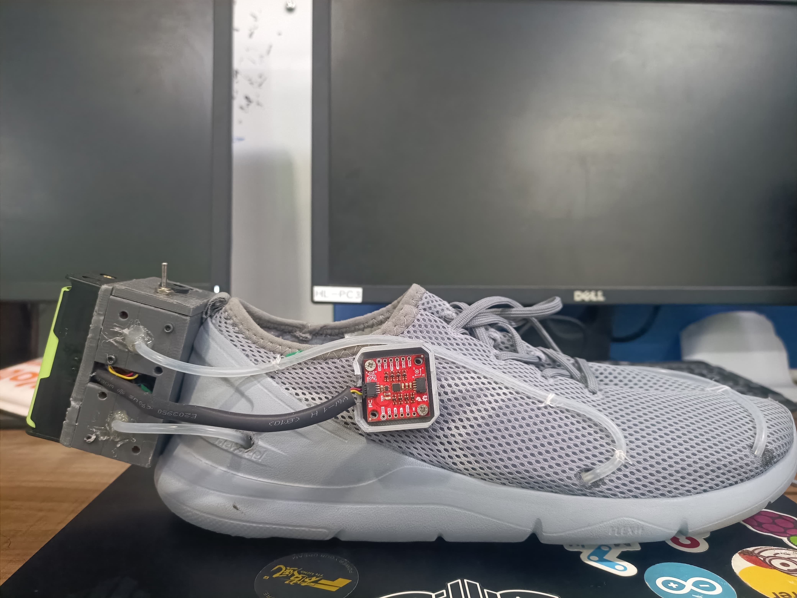
Images/WhatsApp Image 2024-10-03 at 14.58.51_cc8e7d46.jpg
