Dhruv242003/GRF_Shoe/Images/WhatsApp Image 2024-10-03 at 15.12.05_6fa1a63e.jpg

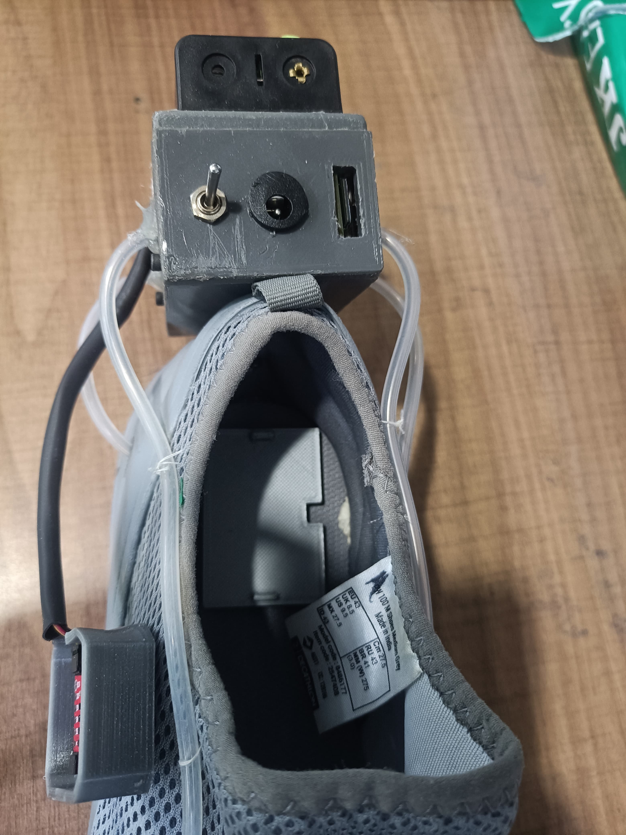
Images/WhatsApp Image 2024-10-03 at 15.12.05_6fa1a63e.jpg
