Dhruv242003/GRF_Shoe/Images/WhatsApp Image 2024-11-19 at 17.02.22_a4100007.jpg

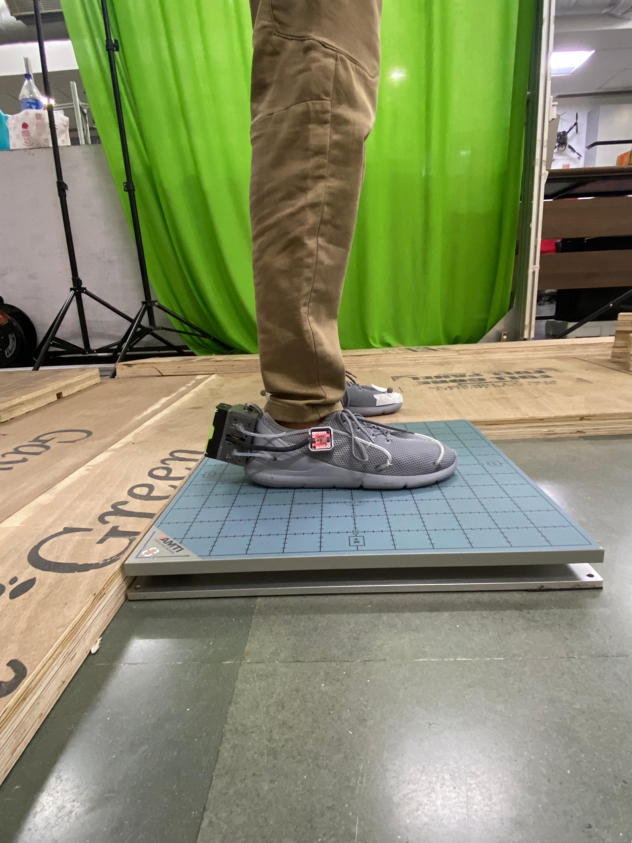
Images/WhatsApp Image 2024-11-19 at 17.02.22_a4100007.jpg
