Dhruv242003/GRF_Shoe/Images/WhatsApp Image 2024-11-19 at 17.02.23_69b9697d.jpg

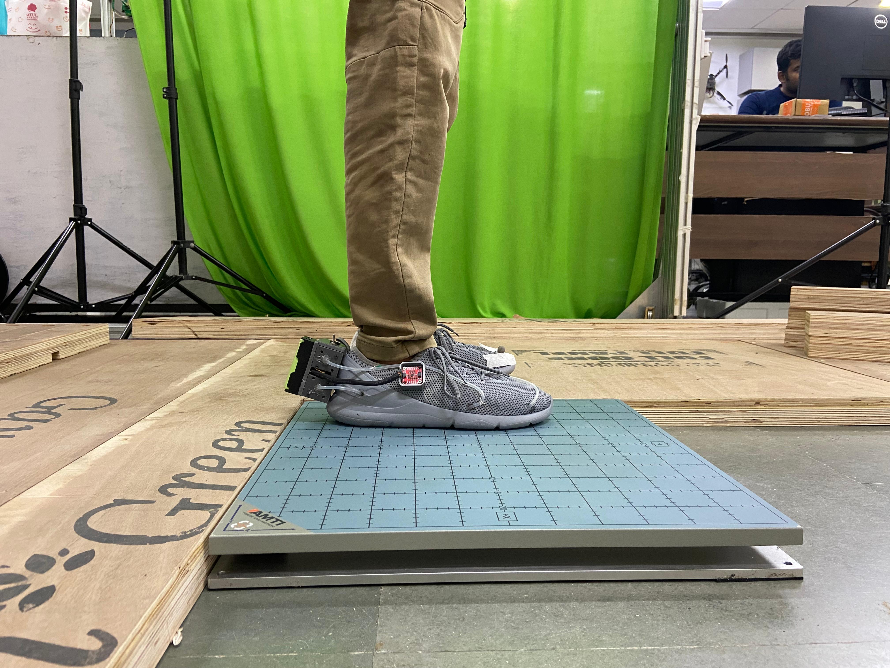
Images/WhatsApp Image 2024-11-19 at 17.02.23_69b9697d.jpg
