Dhruv242003/GRF_Shoe/Images/WhatsApp Image 2024-11-19 at 17.02.24_6ba7e8aa.jpg

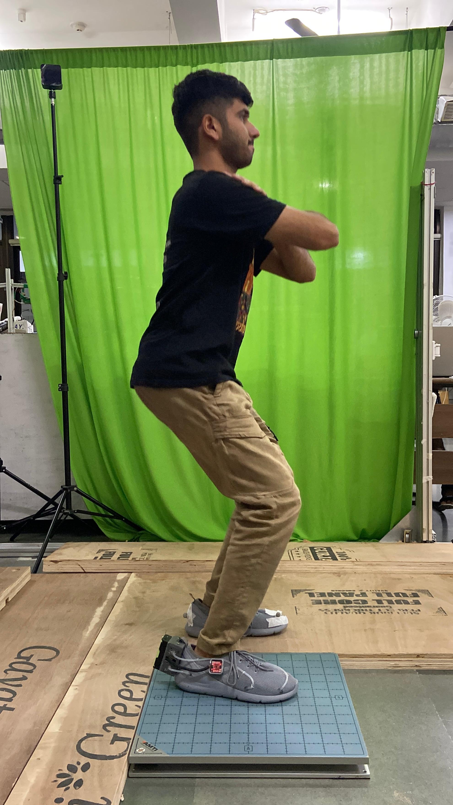
Images/WhatsApp Image 2024-11-19 at 17.02.24_6ba7e8aa.jpg
