Dhruv242003/GRF_Shoe/Images/WhatsApp Image 2024-11-20 at 21.49.56_f22b188d.jpg

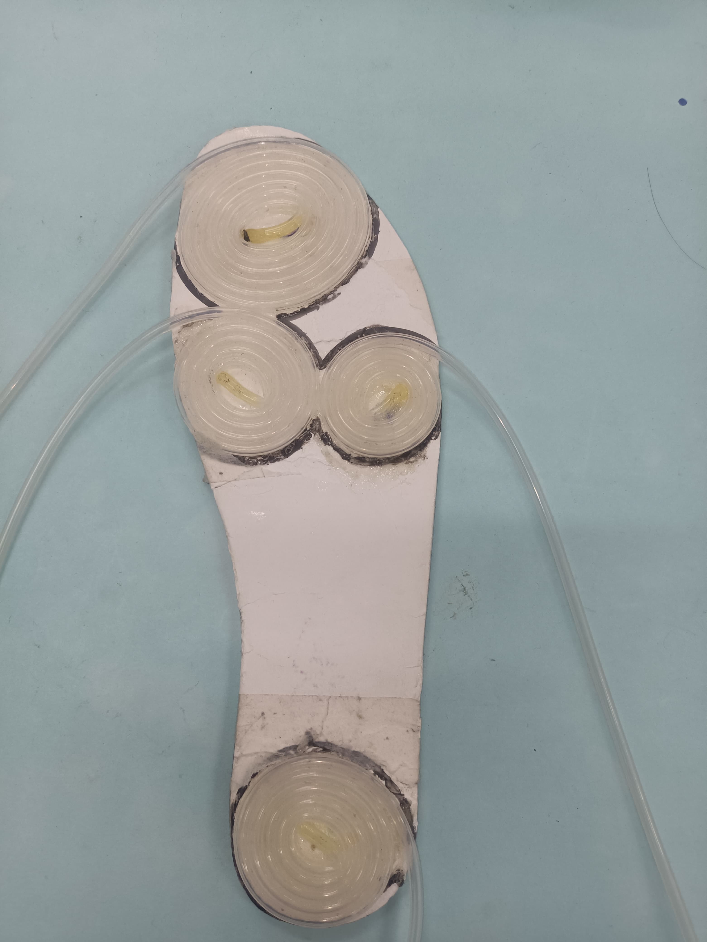
Images/WhatsApp Image 2024-11-20 at 21.49.56_f22b188d.jpg
