Dhruv242003/GRF_Shoe/Images/WhatsApp Image 2025-03-04 at 12.40.21_5db30f4b.jpg

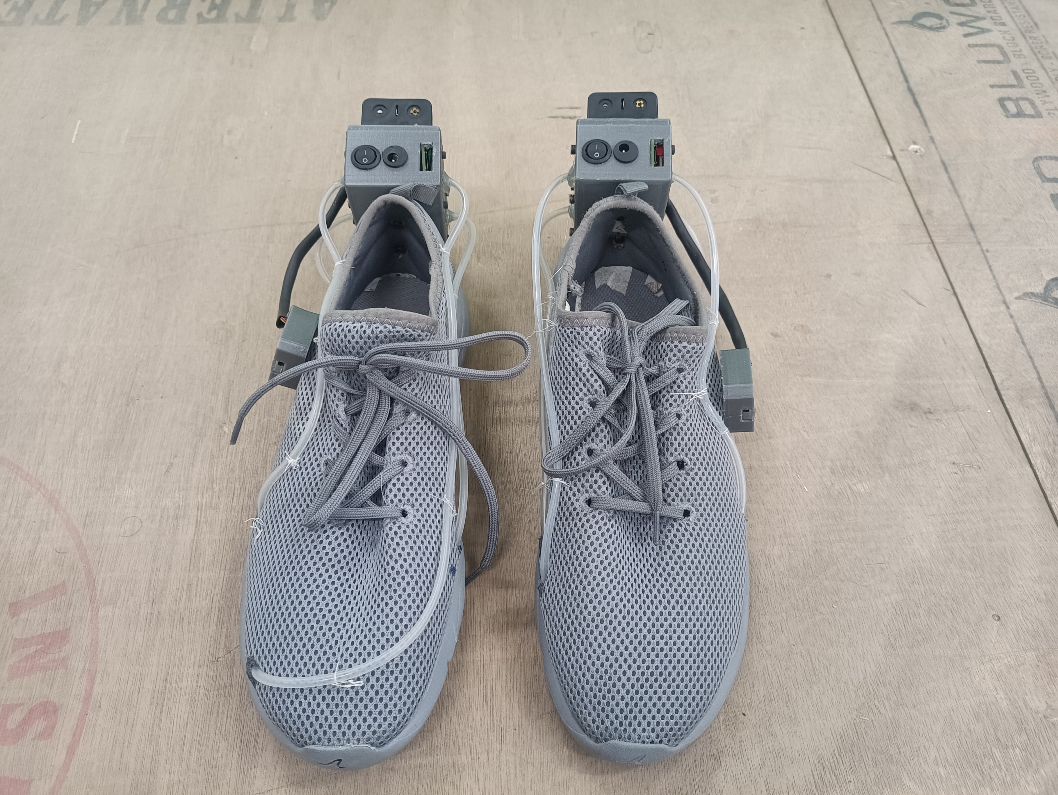
Images/WhatsApp Image 2025-03-04 at 12.40.21_5db30f4b.jpg
