Dhruv242003/GRF_Shoe/Images/WhatsApp Image 2025-03-04 at 12.40.22_530c6308.jpg

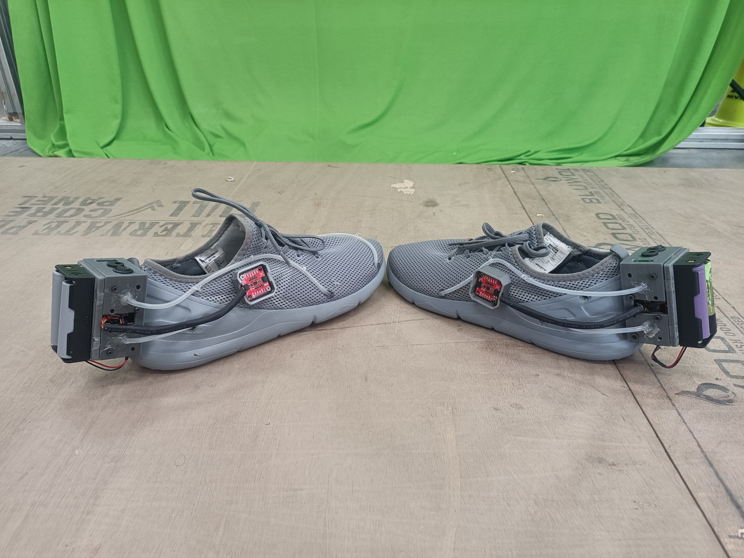
Images/WhatsApp Image 2025-03-04 at 12.40.22_530c6308.jpg
