Dhruv242003/GRF_Shoe/Images/WhatsApp_Image_2024-10-03_at_14.58.50_570be8ac-removebg-preview.png

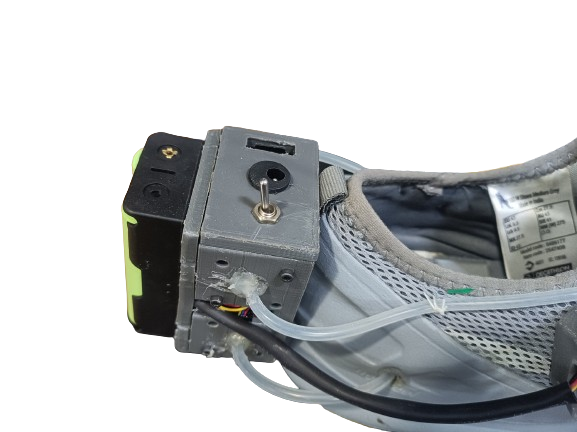
Images/WhatsApp_Image_2024-10-03_at_14.58.50_570be8ac-removebg-preview.png
