Dhruv242003/GRF_Shoe/Images/WhatsApp_Image_2024-10-03_at_14.58.51_cc8e7d46-removebg-preview.png

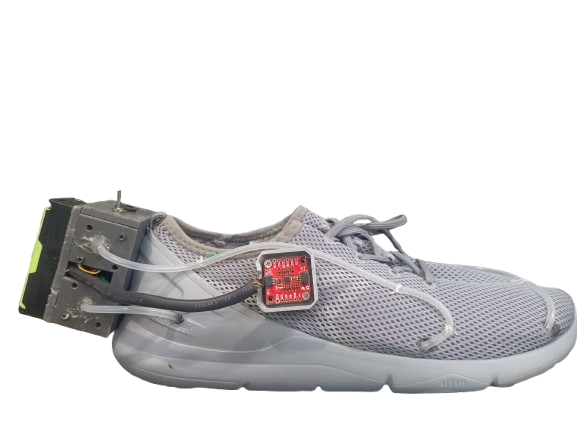
Images/WhatsApp_Image_2024-10-03_at_14.58.51_cc8e7d46-removebg-preview.png
