Dhruv242003/GRF_Shoe/Images/WhatsApp_Image_2024-11-20_at_21.49.56_f22b188d-removebg-preview.png

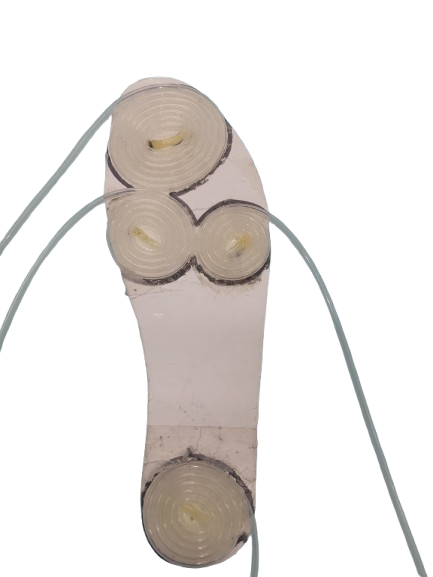
Images/WhatsApp_Image_2024-11-20_at_21.49.56_f22b188d-removebg-preview.png
