Dhruv242003/GRF_Shoe/CAD/Pressure_sensor_case v18.stl

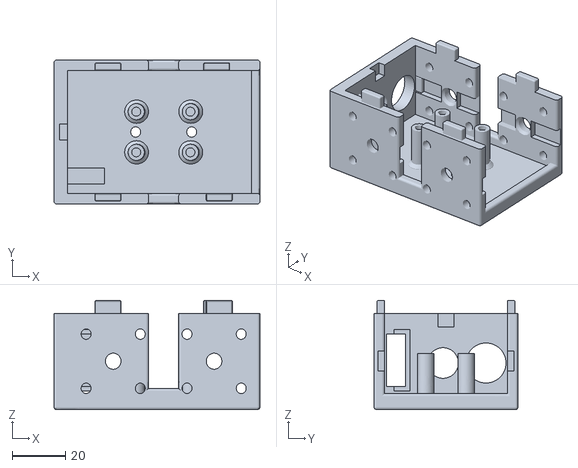
[picture p100: CAD file, 2025-02-18]
CAD/Pressure_sensor_case v18.stl
77.2 x 54.0 x 41.0
