Dhruv242003/GRF_Shoe/CAD/Side_Cap v4.stl

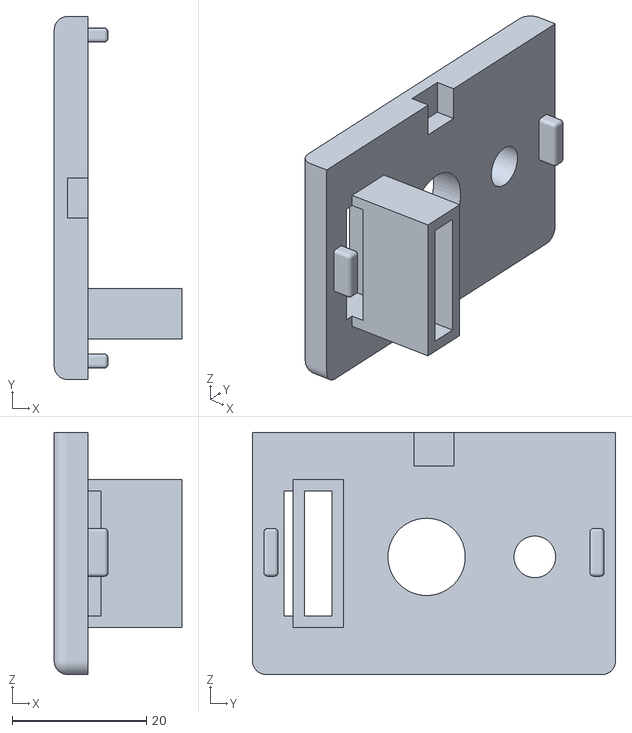
[picture p101: CAD file, 2024-10-07]
CAD/Side_Cap v4.stl
19.0 x 54.0 x 36.0
