Dhruv242003/GRF_Shoe/CAD/Side_Cap_2 v2.stl

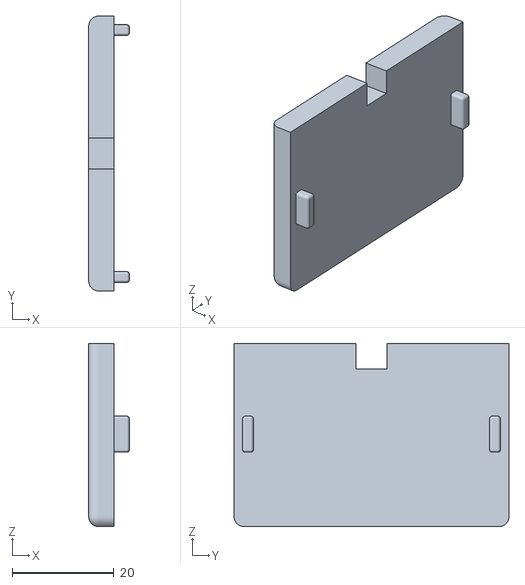
[picture p102: CAD file, 2024-09-23]
CAD/Side_Cap_2 v2.stl
8.00 x 54.0 x 36.0
