Dhruv242003/GRF_Shoe/CAD/Pressure_sensor_case_top_lid v3.stl

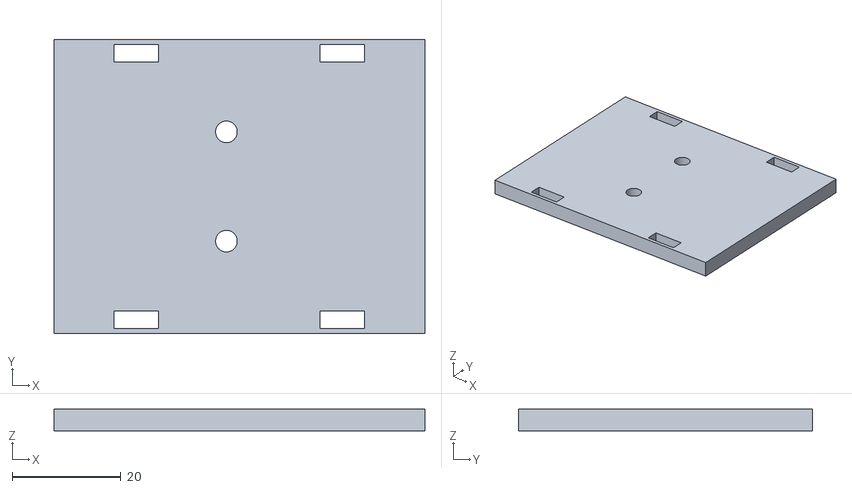
[picture p103: CAD file, 2024-09-18]
CAD/Pressure_sensor_case_top_lid v3.stl
68.2 x 54.0 x 4.00
