Dhruv242003/GRF_Shoe/CAD/IMU_mount_Cap v2.stl

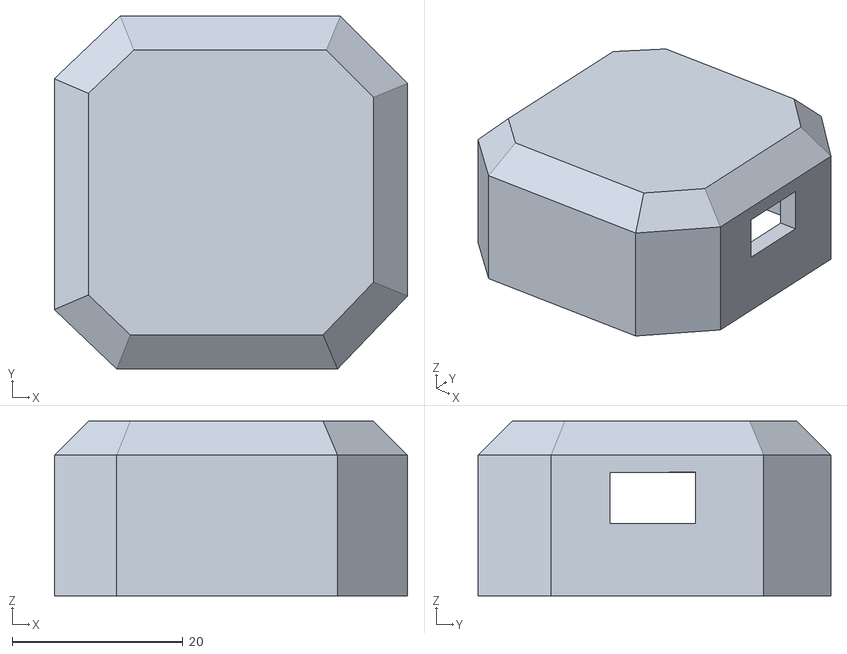
[picture p104: CAD file, 2024-09-18]
CAD/IMU_mount_Cap v2.stl
41.4 x 41.4 x 20.5
