Dhruv242003/GRF_Shoe/CAD/IMU_mount v3.stl

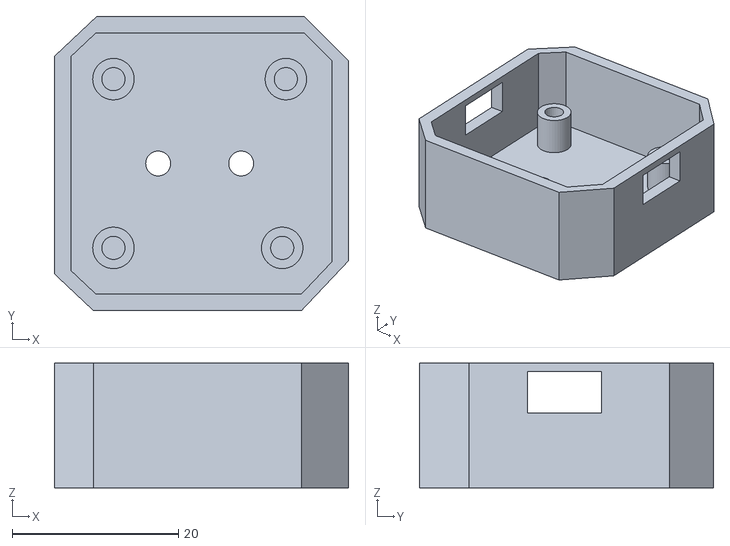
[picture p105: CAD file, 2024-09-18]
CAD/IMU_mount v3.stl
35.4 x 35.4 x 15.0
