Dhruv242003/GRF_Shoe/CAD/Top_lid v8.stl

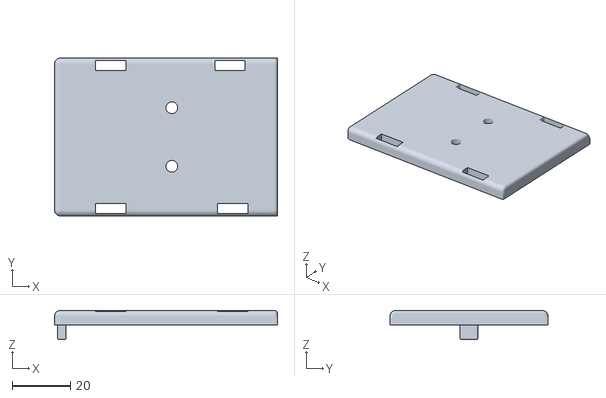
[picture p106: CAD file, 2024-09-18]
CAD/Top_lid v8.stl
76.2 x 54.0 x 10.0
