Dhruv242003/GRF_Shoe/CAD/pressure_sensor_case.step

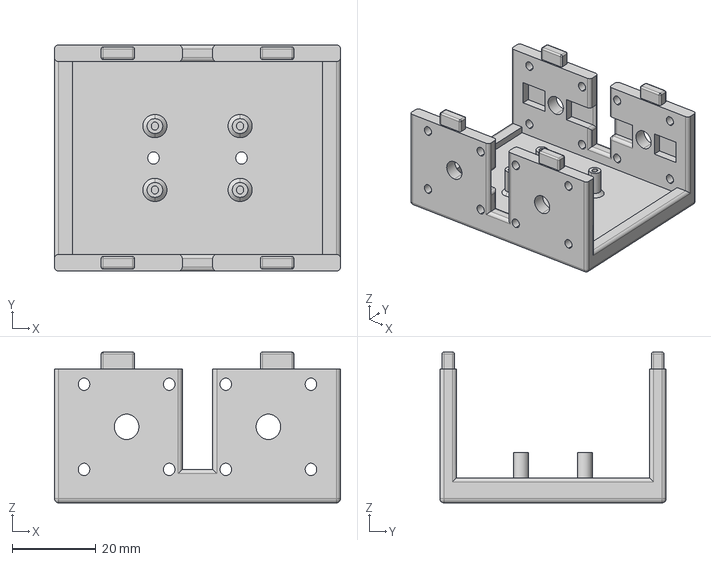
[picture p107: CAD file, 2024-09-18]
CAD/pressure_sensor_case.step
68.2 x 54.0 x 36.0 mm
