Dhruv242003/GRF_Shoe/CAD/laptop_stand v4.stl

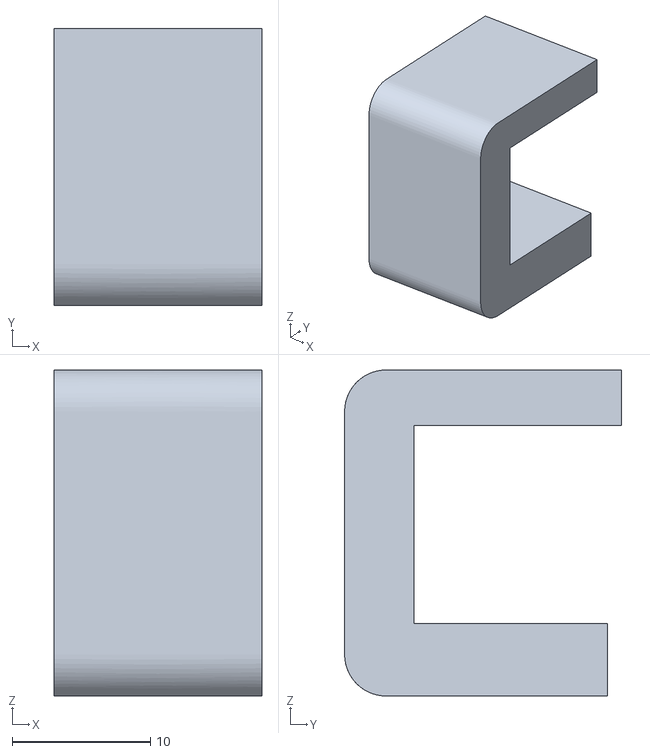
[picture p108: CAD file, 2024-09-18]
CAD/laptop_stand v4.stl
15.0 x 20.0 x 23.5
