Dhruv242003/GRF_Shoe/CAD/Pressure_sensor_case v13.stl

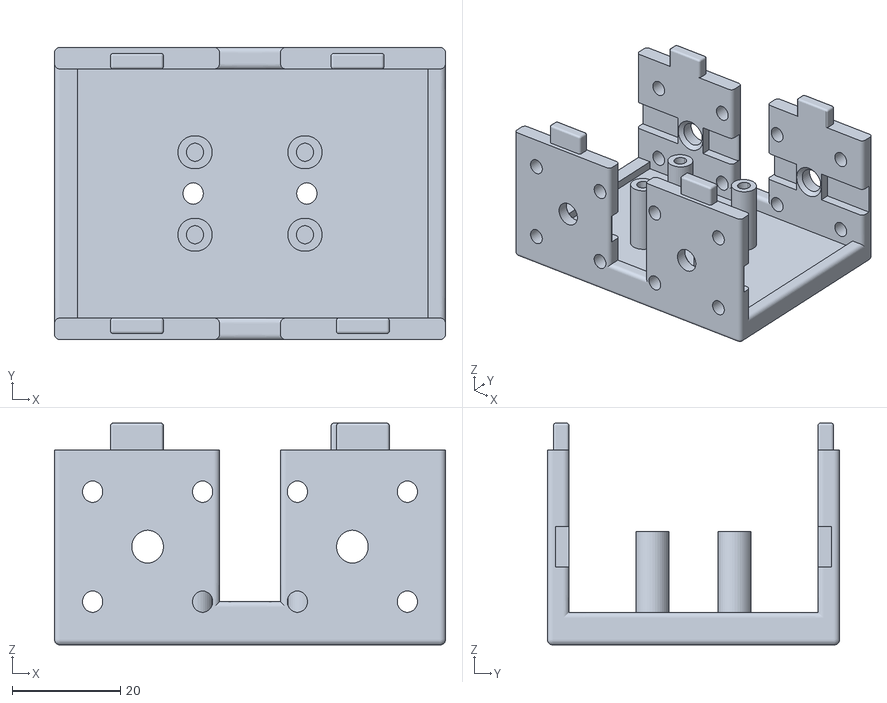
[picture p109: CAD file, 2024-09-23, an earlier design]
CAD/Pressure_sensor_case v13.stl
72.2 x 54.0 x 41.0
