Dhruv242003/GRF_Shoe/CAD/laptop_stand v2.stl

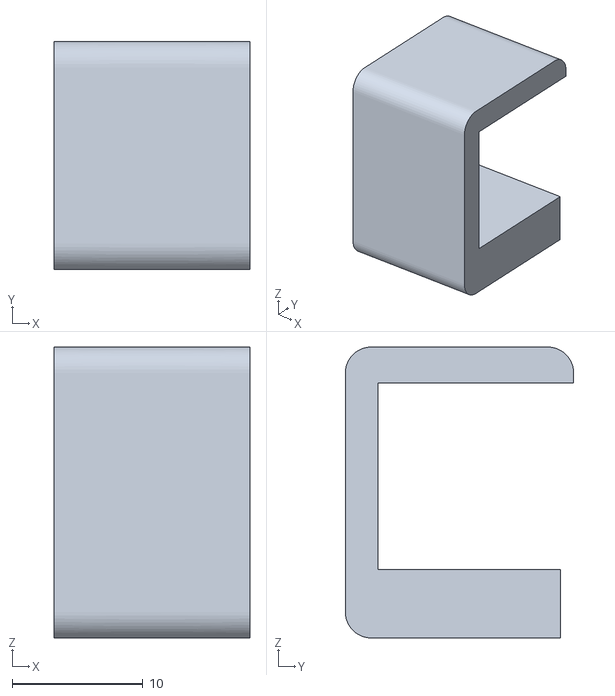
[picture p110: CAD file, 2024-09-18, an earlier design]
CAD/laptop_stand v2.stl
15.0 x 17.5 x 22.3
