Dhruv242003/GRF_Shoe/CAD/Pressure_sensor_case v9.stl

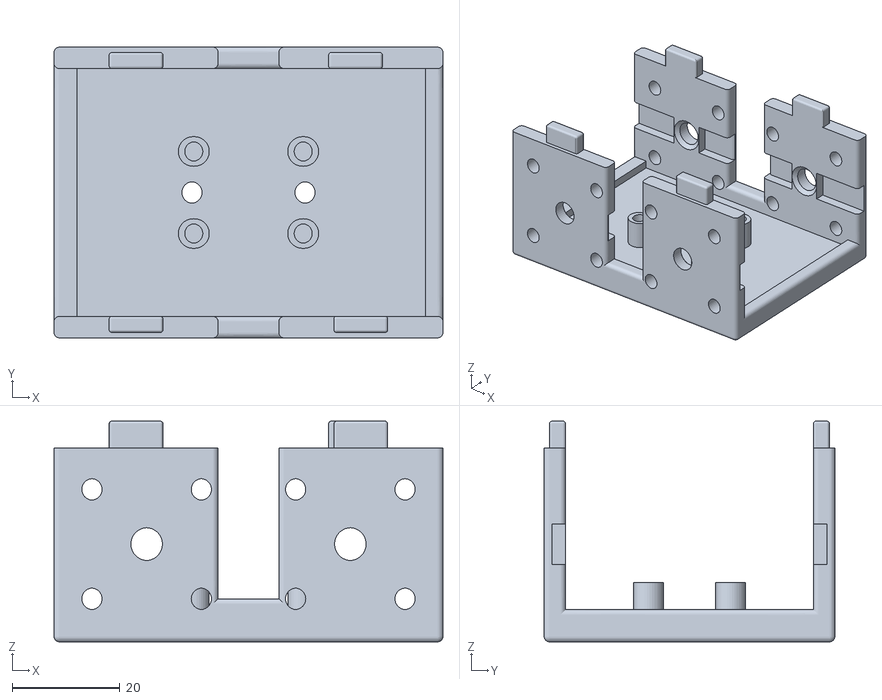
[picture p111: CAD file, 2024-09-18, an earlier design]
CAD/Pressure_sensor_case v9.stl
72.2 x 54.0 x 41.0
