Dhruv242003/GRF_Shoe/CAD/Top_lid v4.stl

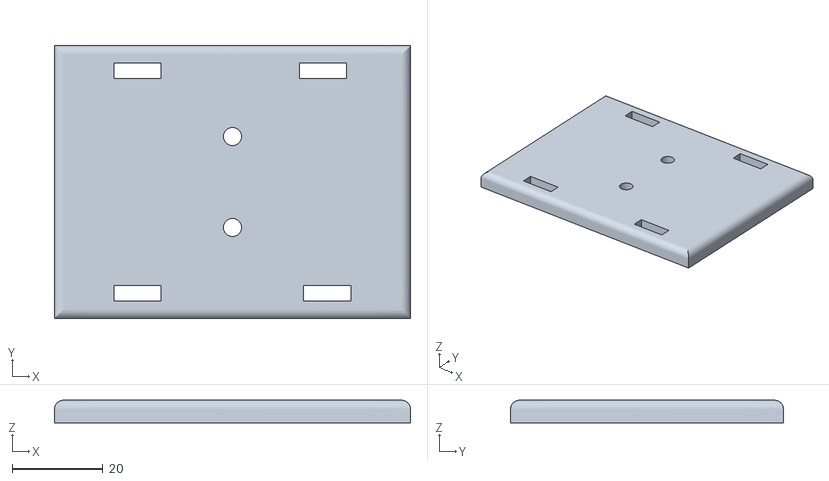
[picture p112: CAD file, 2024-09-18, an earlier design]
CAD/Top_lid v4.stl
78.2 x 60.0 x 5.00
