Dhruv242003/GRF_Shoe/CAD/IMU_mount v1.stl

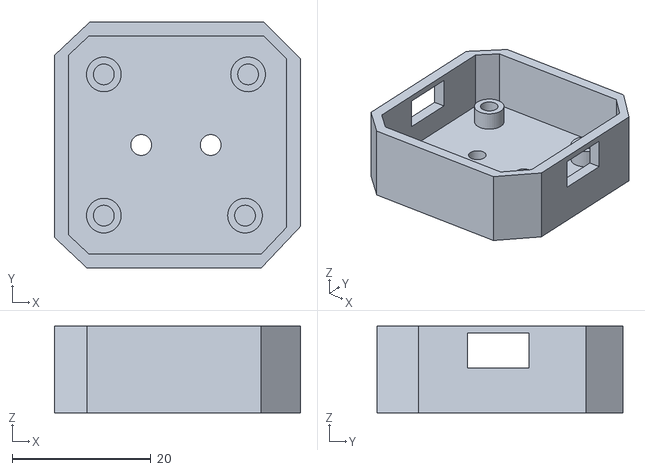
[picture p113: CAD file, 2024-09-18, an earlier design]
CAD/IMU_mount v1.stl
35.4 x 35.4 x 12.5
