Dhruv242003/GRF_Shoe/(list of files, cad)

Other CAD files:
CAD/Side_Cap v2.stl
CAD/laptop_stand v1.stl
CAD/Top_lid v3.stl
CAD/Side_Cap v1.stl
CAD/IMU_mount_Cap v1.stl
CAD/Pressure_sensor_case v5.stl
CAD/Pressure_sensor_case v9.f3d
CAD/Top_lid v2.stl
