Dhruv242003/GRF_Shoe/CAD/Assembly v2 2.png

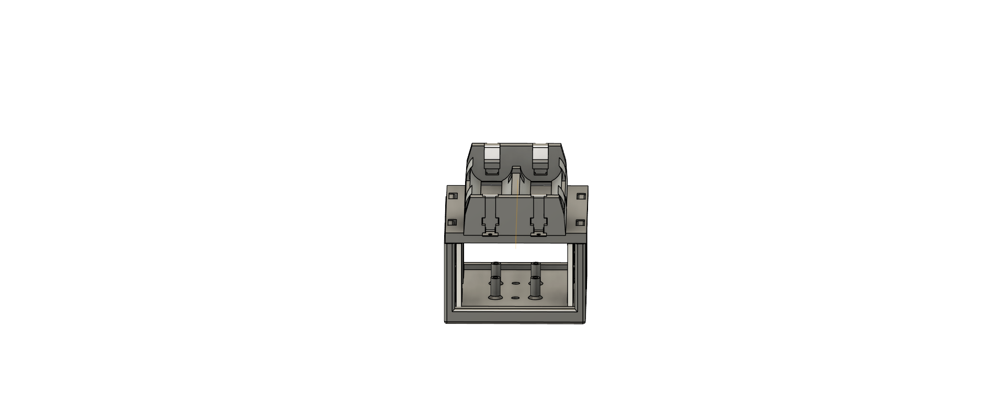
CAD/Assembly v2 2.png
