Dhruv242003/GRF_Shoe/CAD/Assembly v2 3.png

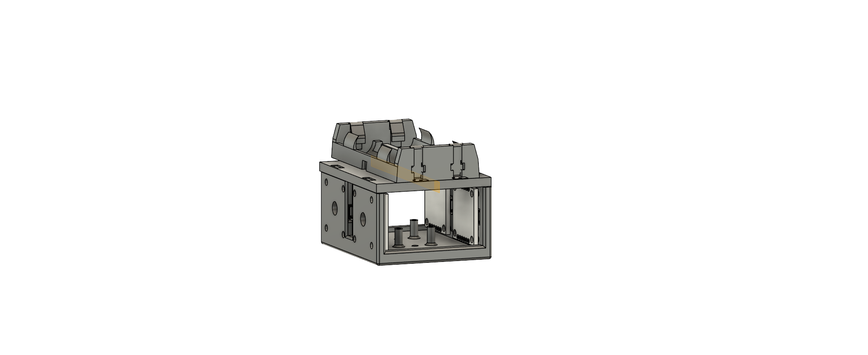
CAD/Assembly v2 3.png
