Dhruv242003/GRF_Shoe/Data/RealTime/Dhruv/combinedResult.csv

currTime | s1 | s2 | s3 | s4 | s | AccX | AccY | AccZ | GyroX | GyroY | GyroZ | GRF | Frame | SubFrame | Fx | Fy | Fz | Mx | My | Mz | Cx | Cy | Cz | Weight
13162 | 798.57 | 769.77 | 755.54 | 762.63 | 771.63 | -244.14 | -748.05 | 460.94 | 114.61 | -39.19 | 4.6 | -133.09 | 2633 | 0 | 4.37544 | -9.79598 | -63.6968 | 1405.25 | -3975.75 | -341.703 | -560.399 | -22.0277 | 0 | 56
13200 | 811.15 | 771.9 | 755.98 | 765.75 | 776.19 | -32.23 | -818.36 | 705.08 | -0.86 | -12.73 | 0.8 | -228.21 | 2641 | 0 | 27.4493 | -15.2969 | -267.821 | 15197.9 | -19175.4 | 738.782 | -569.569 | -56.6518 | 0 | 56
13236 | 819.35 | 773.68 | 756.22 | 766.81 | 779.01 | -27.83 | -748.05 | 687.99 | -2.1 | 1.24 | -2.31 | -280.38 | 2648 | 0 | 41.3485 | -5.11797 | -417.146 | 25203.2 | -31639.5 | 1028.83 | -573.848 | -60.4199 | 0 | 56
13271 | 820.98 | 774.18 | 756.17 | 766.33 | 779.42 | -52.73 | -754.39 | 696.78 | -4.55 | 2.24 | -0.84 | -284.06 | 2655 | 0 | 54.4086 | 11.9243 | -490.734 | 26876.2 | -37339.2 | 314.524 | -574.088 | -54.7688 | 0 | 56
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
