Dhruv242003/GRF_Shoe/Data/RealTime/RealTime_test.csv

s1 | s2 | s3 | s4 | Weight
801.66 | 772.33 | 763.26 | 770.69 | 55
801.94 | 772.3 | 763.17 | 770.9 | 55
801.86 | 772.43 | 763.23 | 770.97 | 55
802.05 | 772.52 | 763.2 | 771.04 | 55
802.15 | 772.77 | 763.23 | 771.03 | 55
802.46 | 772.79 | 763.22 | 771.11 | 55
803.04 | 773.14 | 763.28 | 771.27 | 55
803.5 | 773.44 | 763.36 | 771.47 | 55
804.18 | 773.57 | 763.32 | 771.43 | 55
804.82 | 773.76 | 763.28 | 771.31 | 55
805.24 | 773.73 | 763.23 | 771.22 | 55
805.32 | 773.69 | 763.22 | 771.32 | 55
804.98 | 774.29 | 763.26 | 771.52 | 55
804.56 | 774.58 | 763.24 | 771.31 | 55
804.88 | 774.83 | 763.17 | 770.92 | 55
806.21 | 774.79 | 763.07 | 769.6 | 55
807.83 | 774.46 | 762.94 | 768.16 | 55
810.32 | 774.16 | 762.7 | 766.35 | 55
811.88 | 773.3 | 762.36 | 764.75 | 55
810.77 | 772.4 | 762.23 | 764.05 | 55
809.84 | 771.17 | 762.11 | 763.6 | 55
809.21 | 770.3 | 761.96 | 763.38 | 55
810.08 | 769.55 | 762.02 | 763.32 | 55
810.84 | 769.05 | 761.96 | 763.17 | 55
809.74 | 768.14 | 762.05 | 762.94 | 55
811.81 | 768.21 | 762.12 | 762.94 | 55
812.86 | 768.01 | 761.98 | 762.92 | 55
811.98 | 768.15 | 761.97 | 763.05 | 55
812.91 | 768.79 | 762.11 | 763.29 | 55
814.27 | 768.55 | 762.15 | 763.27 | 55
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
