Dhruv242003/GRF_Shoe/Data/Squats/combinedResult.csv

currTime | s1 | s2 | s3 | s4 | s | AccX | AccY | AccZ | GyroX | GyroY | GyroZ | Frame | SubFrame | Fx | Fy | Fz | Mx | My | Mz | Cx | Cy | Cz
22 | 0 | 0 | 0 | 0 | 0 | -93.75 | -825.68 | 618.65 | -8.27 | -12.47 | 2.98 | 4 | 0 | 0 | 0 | 0 | 0 | 0 | 0 | 0 | 0 | 0
53 | 0 | 0 | 0 | 0 | 0 | -147.46 | -1017.09 | 264.16 | 12.27 | -16.34 | -2.05 | 11 | 0 | 0 | 0 | 0 | 0 | 0 | 0 | 0 | 0 | 0
84 | 0 | 0 | 0 | 0 | 0 | -28.81 | -864.75 | 615.72 | -7.39 | 6.64 | -0.26 | 17 | 0 | 0 | 0 | 0 | 0 | 0 | 0 | 0 | 0 | 0
114 | 0 | 0 | 0 | 0 | 0 | -18.07 | -838.38 | 572.27 | 1.39 | 0.05 | -1.24 | 23 | 0 | 0 | 0 | 0 | 0 | 0 | 0 | 0 | 0 | 0
148 | 0 | 0 | 0 | 0 | 0 | -32.71 | -863.77 | 542.97 | 1.64 | 0.23 | -3.01 | 30 | 0 | 0 | 0 | 0 | 0 | 0 | 0 | 0 | 0 | 0
179 | 0 | 0 | 0 | 0 | 0 | -26.86 | -862.79 | 541.02 | 1.18 | -1.28 | -1.44 | 36 | 0 | 0 | 0 | 0 | 0 | 0 | 0 | 0 | 0 | 0
209 | 0 | 0 | 0 | 0 | 0 | -19.53 | -858.4 | 547.85 | -0.31 | -1.45 | 0.17 | 42 | 0 | 0 | 0 | 0 | 0 | 0 | 0 | 0 | 0 | 0
240 | 0 | 0 | 0 | 0 | 0 | -17.09 | -851.07 | 564.94 | 0.08 | 1.18 | -0.03 | 48 | 0 | 0 | 0 | 0 | 0 | 0 | 0 | 0 | 0 | 0
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
