Dhruv242003/GRF_Shoe/Data/TorrTrials/Dharmesh/combinedResult.csv

currTime | s1 | s2 | s3 | s4 | s | AccX | AccY | AccZ | GyroX | GyroY | GyroZ | Frame | SubFrame | Fx | Fy | Fz | Mx | My | Mz | Cx | Cy | Cz | Weight
10933 | 753.11 | 767.04 | 757.07 | 760.07 | 759.32 | -41.5 | -1004.39 | 252.93 | 33.02 | -0.21 | 20.31 | 2188 | 0 | 2.99292 | 2.70722 | -27.4957 | 242.428 | -1332.24 | 86.8712 | -547.447 | -8.83537 | 0 | 72
10964 | 753.13 | 767.57 | 757.27 | 760.87 | 759.71 | -71.78 | -997.56 | 300.78 | 34.79 | 9.53 | 16.33 | 2194 | 0 | 5.38603 | 4.27523 | -36.213 | 364.264 | -1485.87 | 81.7844 | -540.031 | -10.0576 | 0 | 72
10995 | 753.92 | 768.25 | 757.74 | 761.84 | 760.44 | -159.67 | -829.59 | 600.59 | 33.8 | -13.22 | 0.87 | 2200 | 0 | 8.6344 | 2.88159 | -46.3032 | 621.342 | -1724.26 | 438.94 | -536.261 | -13.4155 | 0 | 72
11026 | 755.37 | 769.4 | 758.1 | 762.51 | 761.34 | -114.26 | -870.61 | 553.22 | 53.29 | 10.66 | -7.92 | 2206 | 0 | 12.4037 | 3.39761 | -61.0527 | 949.118 | -1867.05 | 598.172 | -529.581 | -15.5375 | 0 | 72
11056 | 757.14 | 771 | 758.35 | 762.89 | 762.34 | -18.07 | -918.46 | 462.89 | 26.05 | 1.84 | -6.6 | 2212 | 0 | 12.9586 | 1.86141 | -86.5583 | 2992.85 | -2993.11 | 387.156 | -533.571 | -34.5533 | 0 | 72
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
