Dhruv242003/GRF_Shoe/Data/TorrTrials/Dhruv/combinedResult.csv

currTime | s1 | s2 | s3 | s4 | s | AccX | AccY | AccZ | GyroX | GyroY | GyroZ | Frame | SubFrame | Fx | Fy | Fz | Mx | My | Mz | Cx | Cy | Cz | Weight
17704 | 758.24 | 758.92 | 751.84 | 754.45 | 755.86 | -228.03 | -849.61 | 594.73 | 23.07 | -0.02 | 1.92 | 3542 | 0 | 9.46627 | -3.0171 | -36.5733 | 3934.21 | -6699.31 | 2296.04 | -183.177 | -107.574 | 0 | 56
17735 | 762.59 | 759.15 | 751.94 | 754.85 | 757.13 | -60.55 | -889.16 | 511.72 | 27.24 | -2.84 | -4.61 | 3548 | 0 | 10.0006 | 2.77228 | -56.5002 | 4186.57 | -9011.18 | 1665.11 | -159.489 | -74.0983 | 0 | 56
17766 | 767.6 | 759.28 | 752.06 | 755.61 | 758.64 | -48.34 | -861.82 | 550.78 | 21.63 | -6.4 | -2.11 | 3554 | 0 | 13.2341 | -0.555618 | -80.1259 | 6992.13 | -11774.9 | 1969.2 | -146.955 | -87.2623 | 0 | 56
17797 | 774.18 | 759.55 | 752.33 | 756.56 | 760.66 | -74.22 | -834.96 | 610.84 | 17.4 | -5.53 | -2.05 | 3560 | 0 | 15.941 | 0.107211 | -109.057 | 9263.21 | -15103.5 | 2009.55 | -138.493 | -84.9397 | 0 | 56
17828 | 781.54 | 759.75 | 752.42 | 757.57 | 762.82 | -70.31 | -815.92 | 594.73 | 19.74 | -5.27 | -1.64 | 3567 | 0 | 17.0367 | 1.30424 | -147.882 | 12530.8 | -19864.3 | 1697.63 | -134.326 | -84.735 | 0 | 56
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
