Dhruv242003/GRF_Shoe/Data/TorrTrials/Prasanna/combinedResult.csv

currTime | s1 | s2 | s3 | s4 | s | AccX | AccY | AccZ | GyroX | GyroY | GyroZ | Frame | SubFrame | Fx | Fy | Fz | Mx | My | Mz | Cx | Cy | Cz | Weight
13914 | 768.18 | 765.62 | 754.09 | 761.36 | 762.31 | -106.93 | -704.59 | 568.85 | 54.35 | -15.21 | -17.92 | 2784 | 0 | -2.39425 | -12.4503 | -67.216 | 208.937 | -3355.65 | 736.232 | -49.988 | -3.03961 | 0 | 72
13945 | 767.33 | 766.41 | 754.6 | 763.1 | 762.86 | 112.79 | -825.68 | 603.03 | 6.95 | 11.68 | -10.76 | 2790 | 0 | 40.2502 | -7.98858 | -185.537 | 2788.88 | -1091.47 | 3284.28 | -5.90244 | -15.0128 | 0 | 72
13975 | 772.65 | 768.28 | 755.06 | 765.01 | 765.25 | 68.36 | -776.37 | 605.96 | 36.92 | -10.93 | -10.61 | 2796 | 0 | 42.5117 | -7.3552 | -254.319 | 3300.27 | -747.834 | 2413.27 | -2.94058 | -12.9777 | 0 | 72
14006 | 784.65 | 770.19 | 755.44 | 766.86 | 769.28 | -38.09 | -844.24 | 579.59 | 42.96 | -7.25 | -4.46 | 2802 | 0 | 39.2234 | 10.9719 | -265.529 | 166.927 | -832.535 | 1873.36 | -3.13542 | -0.62922 | 0 | 72
14036 | 797.2 | 771.55 | 755.66 | 767.96 | 773.09 | -41.5 | -894.53 | 579.59 | 14.47 | 3.57 | -0.51 | 2808 | 0 | 48.8133 | 12.1885 | -341.532 | 1825.43 | -180.982 | 1920.09 | -0.531231 | -5.34275 | 0 | 72
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
