Dhruv242003/GRF_Shoe/Images/Validation_DL.png

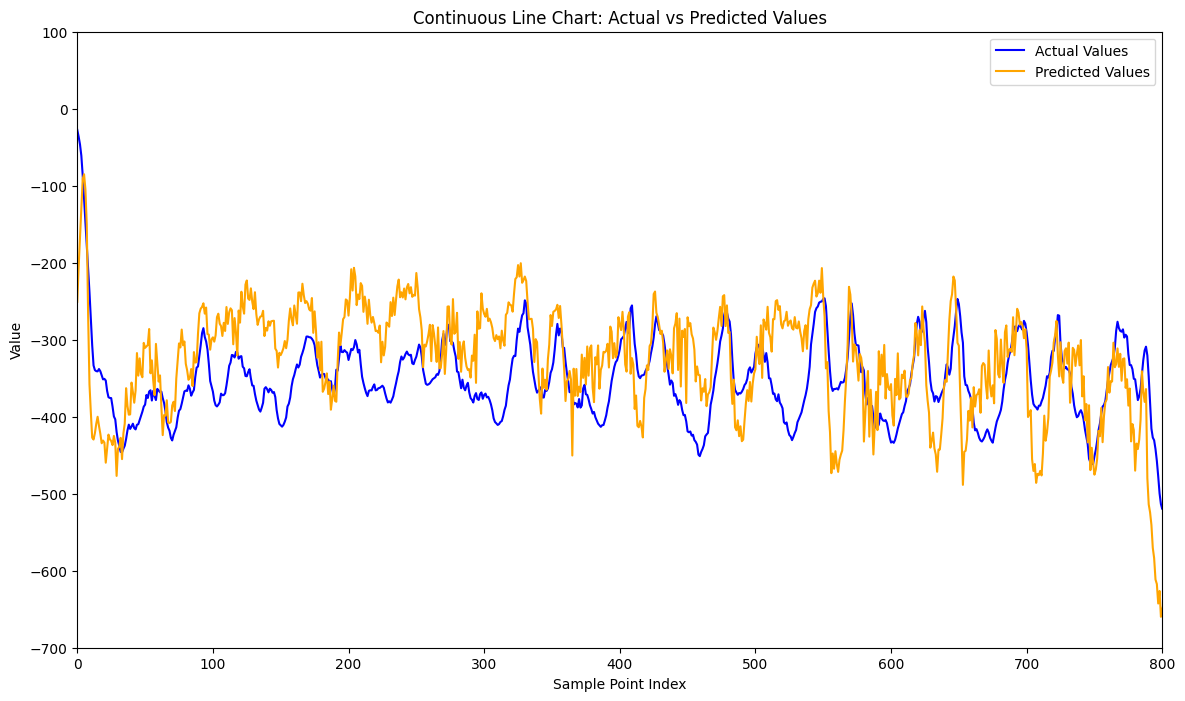
Images/Validation_DL.png
