Dhruv242003/GRF_Shoe/Images/Validation_RandomForest.png

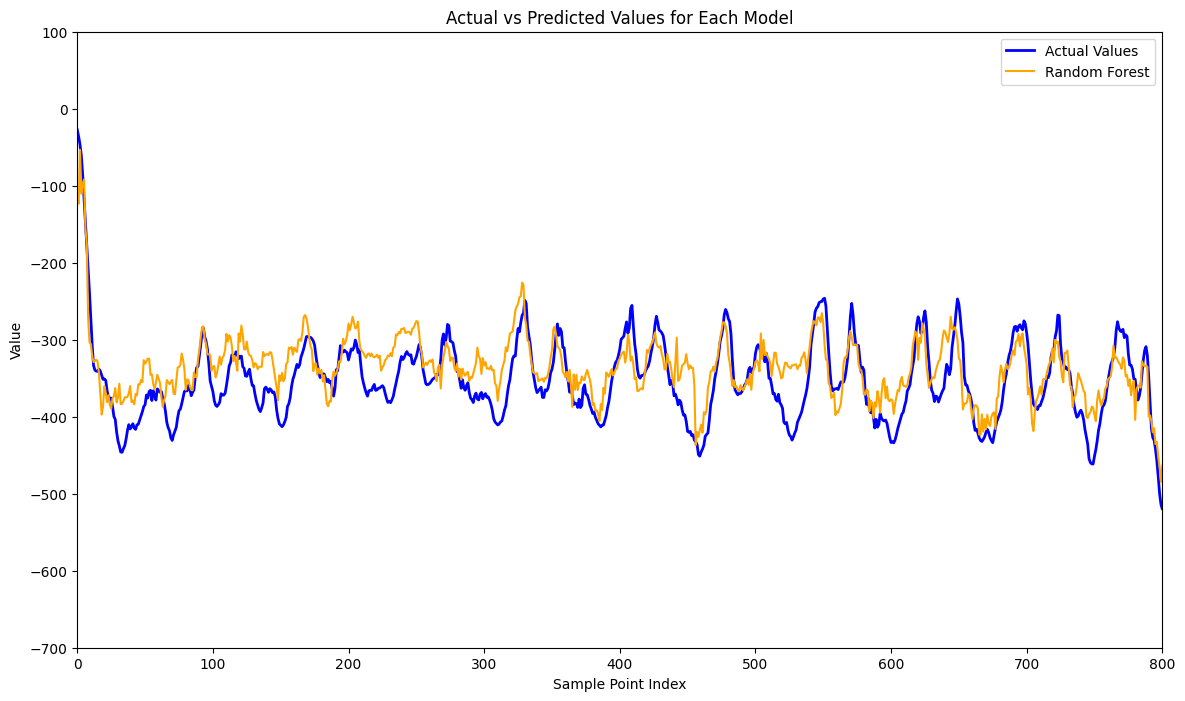
Images/Validation_RandomForest.png
