Dhruv242003/GRF_Shoe/Portenta_Codes/Portenta_Codes/SmartShoe_MicroFlow_Portenta_New_1.ino/SmartShoe_MicroFlow_Portenta_New_1.ino.ino

#include "ICM_20948.h"
#include<Wire.h>
#include <SD.h>
#include <SparkFun_MicroPressure.h>
#include <WiFi.h>
#include <string.h>
#include "MicroFlow.h"

#define AD0_VAL 1  

#ifndef STASSID
#define STASSID "myriohcr" // Name of your router
#define STAPSK  "hcrlab123" // Password of your router
#endif

// const char* ssid      = STASSID;
// const char* password  = STAPSK;
// const int   port      = 49204;
// int status = WL_IDLE_STATUS;
// IPAddress server(172,16,0,1);
// int incomingByte = 0; 
// int data = 1;
// char dataTransmit[10];

// WiFiClient client;

int prev_time = 0;

float accX, accY, accZ, gyroX, gyroY, gyroZ;
float s1, s2, s3, s4, s = 0;
//
//int topology[] = {13, 16, 16, 16, 16, 16, 16, 1};
//double weights[] = {0.37744573, -1.975618, 0.34271008, 0.36747003, 0.22167443, 0.43038625, -0.31267166, -0.41646576, -1.3227768, 0.49677336, -0.1161232, -0.42988172, -0.16588292, 0.14681195, -0.044621557, -2.536467, -0.391296, 0.10750384, 0.033209443, -0.0241099, 0.5231453, 0.16819344, -0.15570402, 0.15094732, -0.015659206, -0.33716857, 0.15223545, 0.45578966, 0.100363046, 0.248147, 0.28430703, -0.067956716, -0.053975664, 0.0008686177, 0.08312839, -0.3165061, 0.47757366, -0.39588106, -0.28590804, 0.043262362, 0.445677, -0.28884894, -0.120381474, -0.10890532, 0.14704984, -0.033850867, -0.4352022, -0.3006125, -0.35928884, 0.3119569, -0.3293259, -0.26154083, 0.47302255, 0.12583975, -0.24285977, -0.22041328, 0.18132246, 0.6205009, -0.1902596, 0.3317355, 0.3145977, 0.1238346, 0.11108615, 0.3878982, 0.3378823, 0.14047259, -0.28860795, -0.1877662, -0.45228952, -0.06310246, 0.18077809, -0.33560473, -0.31519136, -0.24704343, -0.15806174, 0.1502041, -0.012650427, 0.29948828, -0.1105924, 0.37415233, -0.3978164, 0.20559138, 0.06292027, -0.35990143, 0.29314974, -0.05686634, -0.12487453, 0.13252476, 0.17631862, -0.14889689, -0.05089301, -0.33605283, 0.46988136, 0.42896667, -0.4334911, 0.29654628, 0.16995381, -0.35115334, -0.32162967, 0.15313774, -0.17933764, 0.19571239, -0.078693, -0.20972048, -0.38121837, -0.2654721, -0.3239782, 0.38261926, -0.3782034, 0.12796476, 0.29379496, 0.18960771, -0.09306376, 0.43770075, -0.09980196, -0.2630093, 0.58211815, -0.2945069, 0.27543294, -0.016554447, 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
7, -0.034678515, -0.22992934, -0.2593738, -0.25684002, 0.35418996, -0.31401157, 0.80265784, -0.5171602, -0.27458173, -0.30160555, -0.43954524, -0.8370899, -0.5091825, 0.068309925, -0.17601638, -1.0906916, -0.18014944, 0.31128782, -0.4565776, -0.5047798, 0.6576818};
//double biases[] = {-0.016398966, -0.1159133, 0.0, 0.0, -0.00035698657, -0.15729229, 0.0, -0.0026061719, 0.050456237, 0.18308727, 0.0, -0.04166867, 0.080085166, -0.08525059, 0.20133582, -0.07090731, -0.09753101, -0.016535325, 0.0, 0.070504725, -0.089041434, -0.05656308, -0.00568247, 0.0, 0.13853216, -0.1349743, 0.019823767, 0.04516028, 0.0075938064, -0.028343549, -0.08955264, -0.10335885, 0.046775635, -0.0371664, -0.08606679, 0.02094636, 0.075214125, -0.033210773, 0.017462015, -0.052028697, -0.2960243, -0.015191593, 0.095562, -0.07043441, 0.0, -0.1325552, 0.090032555, -0.0106325885, -0.031438436, 0.06176706, 0.13765262, -0.14307632, 0.0, -0.16398881, 0.040267486, 0.0026020173, -0.07511298, -0.07429017, 0.03455117, -0.05724263, 0.10309279, -0.021617522, 0.05632395, 0.06202442, 0.115279905};
//int layers = 8;


#define PCAADDR 0x70

SparkFun_MicroPressure mpr1; 
SparkFun_MicroPressure mpr2;
SparkFun_MicroPressure mpr3;
SparkFun_MicroPressure mpr4;

ICM_20948_I2C myICM; // Otherwise create an ICM_20948_I2C object

void pcaselect(uint8_t i) {
  // if (i > 3) return;
 
  // Wire.beginTransmission(PCAADDR);
  // Wire.write(1 << i);
  // Wire.endTransmission();  
}

// SD Card Config +++++++++++++++++++++++++++++++++++++++++++++++++++++++++++++++++++++++++++++++++++++++++++++++

#define FILE_BASE_NAME "DATA"  

File file;                                                                                          // Chip Select Pin
int cs_pin = 7;                                                                                    // initialize file name, plus a null terminator        
int count = 0;
char fileName[22] = FILE_BASE_NAME "00.csv";
float cTime;


int avg_size = 100; 
static int baseline_value_1;
static int baseline_value_2;
static int baseline_value_3;
static int baseline_value_4;

int current_value_1 = 0;
int current_value_2 = 0;
int current_value_3 = 0;
int current_value_4 = 0;
int offset_value_1;
int offset_value_2;
int offset_value_3;
int offset_value_4;
float final_value_1, final_value_2, final_value_3, final_value_4;

//MicroMLP mlp(layers, topology, weights, biases, RELU);
//double grf;

void setup(){
//  while (!Serial) {  
//    ;
//  }
  
  Wire.begin();
  Serial.begin(2000000);
  delay(5000);
  
// Wifi Syncing +++++++++++++++++++++++++++++++++++++++++++++++++++++++++++++++++++++++++++++++++++++++++++++++

  Serial.println("It is connecting...");
  // pinMode(LEDR,LOW);
  // pinMode(LEDG,HIGH);
  // pinMode(LEDB,LOW);
  Serial.println("Still connecting...");
  
  status = WiFi.begin(ssid,password);
  Serial.println("Ater Wifi Begin connecting...");
  
  if ( status != WL_CONNECTED) {
    Serial.println("Couldn't get a wifi connection");
    while(true);
    digitalWrite(LEDR,LOW);                                          
    digitalWrite(LEDG,LOW);                                        
    digitalWrite(LEDB,HIGH); 
  }
  else {
    Serial.println("Connected to wifi");
    Serial.println("\nStarting connection...");
    if (client.connect(server, port)) {
      Serial.println("connected");
      pinMode(LEDR,HIGH);
      pinMode(LEDG,LOW);
      pinMode(LEDB,HIGH); 
    }
  }
  Serial.println("Before Wifi Status connecting...");
  printWiFiStatus();

  //delay(2000);
   // Blink Portenta LED Yellow ++++++++++++++++++++++++++++++++++++++++++++++++++++++++++++++++++++++++++++++++++++
    
  digitalWrite(LEDR,LOW);                                        
  digitalWrite(LEDG,LOW);                                        
  digitalWrite(LEDB,HIGH);  

  // Reading Average Baseline Pressure Values ---------------------------------------------------------------------------------------------------------------------------------------------------


  baseline_value_1 = 0;
  baseline_value_2 = 0;
  baseline_value_3 = 0;
  baseline_value_4 = 0;
  
  //Serial.println("Done averaging baseline values...");

  
  #ifdef USE_SPI
  SPI_PORT.begin();
#else
  Wire.begin();
  Wire.setClock(400000);
#endif

  bool initialized = false;
  while (!initialized)
  {
#ifdef USE_SPI
    myICM.begin(CS_PIN, SPI_PORT, SPI_FREQ); // Here we are using the user-defined SPI_FREQ as the clock speed of the SPI bus
#else
    myICM.begin(Wire, AD0_VAL);
#endif
    Serial.print(F("Initialization of the sensor returned: "));
    Serial.println(myICM.statusString());
    if (myICM.status != ICM_20948_Stat_Ok)
    {
      Serial.println("Trying again...");
      delay(500);
    }
    else
    {
      initialized = true;
    }
  }
  Serial.println("Device connected!");
  myICM.swReset();
  if (myICM.status != ICM_20948_Stat_Ok)
  {
    Serial.print(F("Software Reset returned: "));
    Serial.println(myICM.statusString());
  }
  delay(250);
  myICM.sleep(false);
  myICM.lowPower(false);

  myICM.setSampleMode((ICM_20948_Internal_Acc | ICM_20948_Internal_Gyr), ICM_20948_Sample_Mode_Continuous);
  if (myICM.status != ICM_20948_Stat_Ok)
  {
    Serial.print(F("setSampleMode returned: "));
    Serial.println(myICM.statusString());
  }
  // Set full scale ranges for both acc and gyr
  ICM_20948_fss_t myFSS; // This uses a "Full Scale Settings" structure that can contain values for all configurable sensors
  myFSS.a = gpm4; // (ICM_20948_ACCEL_CONFIG_FS_SEL_e) // gpm2 // gpm4 // gpm8 // gpm16
  myFSS.g = dps2000; // (ICM_20948_GYRO_CONFIG_1_FS_SEL_e) // dps250 // dps500 // dps1000 // dps2000
  myICM.setFullScale((ICM_20948_Internal_Acc | ICM_20948_Internal_Gyr), myFSS);
  if (myICM.status != ICM_20948_Stat_Ok)
  {
    Serial.print(F("setFullScale returned: "));
    Serial.println(myICM.statusString());
  }
  // Set up Digital Low-Pass Filter configuration
  ICM_20948_dlpcfg_t myDLPcfg;    // Similar to FSS, this uses a configuration structure for the desired sensors
  myDLPcfg.a = acc_d473bw_n499bw; // (ICM_20948_ACCEL_CONFIG_DLPCFG_e)
                                  // acc_d246bw_n265bw      - means 3db bandwidth is 246 hz and nyquist bandwidth is 265 hz
                                  // acc_d111bw4_n136bw
                                  // acc_d50bw4_n68bw8
                                  // acc_d23bw9_n34bw4
                                  // acc_d11bw5_n17bw
                                  // acc_d5bw7_n8bw3        - means 3 db bandwidth is 5.7 hz and nyquist bandwidth is 8.3 hz
                                  // acc_d473bw_n499bw

  myDLPcfg.g = gyr_d361bw4_n376bw5; // (ICM_20948_GYRO_CONFIG_1_DLPCFG_e)
                                    // gyr_d196bw6_n229bw8
                                    // gyr_d151bw8_n187bw6Serial.print("Initializing SD card...");

  myICM.setDLPFcfg((ICM_20948_Internal_Acc | ICM_20948_Internal_Gyr), myDLPcfg);
  if (myICM.status != ICM_20948_Stat_Ok)
  {
    Serial.print(F("setDLPcfg returned: "));
    Serial.println(myICM.statusString());
  }
  ICM_20948_Status_e accDLPEnableStat = myICM.enableDLPF(ICM_20948_Internal_Acc, false);
  ICM_20948_Status_e gyrDLPEnableStat = myICM.enableDLPF(ICM_20948_Internal_Gyr, false);
  Serial.print(F("Enable DLPF for Accelerometer returned: "));
  Serial.println(myICM.statusString(accDLPEnableStat));
  Serial.print(F("Enable DLPF for Gyroscope returned: "));
  Serial.println(myICM.statusString(gyrDLPEnableStat));
  // Choose whether or not to start the magnetometer
  myICM.startupMagnetometer();
  if (myICM.status != ICM_20948_Stat_Ok)
  {
    Serial.print(F("startupMagnetometer returned: "));
    Serial.println(myICM.statusString());
  }
  Serial.println();
  Serial.println(F("Configuration complete!"));


  // SD Card Setup -------------------------------------------------------------------------------------------------------------------------------------------------------------------------
  
  pinMode(cs_pin, OUTPUT);
  Serial.print("Initializing SD card...");
  
  if (!SD.begin(cs_pin)) {
    
    Serial.println("Card failed, or not present");
    
    // Blink Portenta LED Red ++++++++++++++++++++++++++++++++++++++++++++++++++++++++++++++++++++++++++++++++++++
    
    digitalWrite(LEDR,LOW);                                          
    digitalWrite(LEDG,HIGH);                                        
    digitalWrite(LEDB,HIGH);                                         
    float startTime = millis();
    while (1);
    
  }
  
  const uint8_t BASE_NAME_SIZE = sizeof(FILE_BASE_NAME) - 1;

  Serial.println("card initialized.");
  while (SD.exists(fileName))
  {
      if (fileName[BASE_NAME_SIZE + 1] != '9')
      {
        fileName[BASE_NAME_SIZE + 1]++;
      }
      else if (fileName[BASE_NAME_SIZE] != '9')
      {
        fileName[BASE_NAME_SIZE + 1] = '0';
        fileName[BASE_NAME_SIZE]++;
      }
      else
      {
        Serial.println("Can't create file name");
        
        // Blink Portenta LED Red ++++++++++++++++++++++++++++++++++++++++++++++++++++++++++++++++++++++++++++++++++++
    
        digitalWrite(LEDR,LOW);                                        
        digitalWrite(LEDG,HIGH);                                        
        digitalWrite(LEDB,HIGH);                                        
      }
  }
  
  // Opening File and Creating Headers +++++++++++++++++++++++++++++++++++++++++++++++++++++++++++++++++++++++++++++++
  
  file = SD.open(fileName, FILE_WRITE);

  file.print("currTime");                       file.print(",");
  file.print("s1");                             file.print(",");
  file.print("s2");                             file.print(",");
  file.print("s3");                             file.print(",");
  file.print("s4");                             file.print(",");
  file.print("s");                              file.print(",");
  file.print("AccX");                           file.print(",");
  file.print("AccY");                           file.print(",");
  file.print("AccZ");                           file.print(",");
  file.print("GyroX");                          file.print(",");
  file.print("GyroY");                          file.print(",");
  file.print("GyroZ");                          //file.print(",");
  //file.print("GRF");
  
//  file.print("s_ax");                           file.print(",");
//  file.print("s_ay");                           file.print(",");
//  file.print("s_az");                           file.print(",");
//  file.print("s_gx");                           file.print(",");
//  file.print("s_gy");                           file.print(",");
//  file.print("s_gz");                                                    
  
  file.println();
  file.close();                                                                                      // Closing File in setup
  
  Serial.println("s1, s2, s3, s4, s, AccX, AccY, AccZ, GyroX, GyroY, GyroZ");   // Legend for Serial Plot
 
  pcaselect(0);
    // setup the 1st sensor
  mpr1.begin();

  pcaselect(1);
  // setup the 2nd sensor
  mpr2.begin();

  pcaselect(2);
  // setup the 3rd sensor
  mpr3.begin();
  
  pcaselect(3);
  // setup the 4th sensor
  mpr4.begin();

  for (int i = 0; i < avg_size; i++){
      
       baseline_value_1 += mpr1.readPressure();                                     
       baseline_value_2 += mpr2.readPressure();                                       
       baseline_value_3 += mpr3.readPressure();
       baseline_value_4 += mpr4.readPressure();
       
     }
     
  baseline_value_1 /= avg_size;
  baseline_value_2 /= avg_size;
  baseline_value_3 /= avg_size;
  baseline_value_4 /= avg_size;


  // Conditions for Offset selection ++++++++++++++++++++++++++++++++++++++++++++++++++++++++++++++++++++++++++++++

  
//  if (baseline_value_1 <= 9000000){
//    offset_value_1 = 9000000;
//    }
//  else if (baseline_value_1 > 9000000){
//    offset_value_1 = 9000000;
//    }
//    
//  if (baseline_value_2, baseline_value_3, baseline_value_4  <= 9900000){
//    //offset_value_1 = 45500;
//    offset_value_2 = 9000000;
//    offset_value_3 = 9000000;
//    offset_value_4 = 9000000; 
//   }
////  if (baseline_value_1 <= 8900000){
////    offset_value_1 = 9500000;
////    }
  
  //delay(1000);
  Serial.println("Sending Trigger:");
  sprintf(dataTransmit,"%d",data);

  Serial.println("Waiting...");

  delay(5000);
  
  client.write(dataTransmit);
  Serial.println(dataTransmit);
}


void loop(){

//  if (!client.connected()) {
//    Serial.println();
//    Serial.println("disconnecting.");
//    client.stop();
////    for(;;)
////      ;
//     }


  
  count = count + 1;
  file = SD.open(fileName, FILE_WRITE);                                                             // Opening the File in Loop

  if(count%2 == 1)
  {
    // Blink Portenta LED Magenta ++++++++++++++++++++++++++++++++++++++++++++++++++++++++++++++++++++++++++++++++++++
    
    digitalWrite(LEDR,LOW);                                        
    digitalWrite(LEDG,HIGH);                                         
    digitalWrite(LEDB,LOW);                                         
  }
  
  else{
    
    // Blink Portenta LED Green ++++++++++++++++++++++++++++++++++++++++++++++++++++++++++++++++++++++++++++++++++++++
    
    digitalWrite(LEDR,HIGH);                                        // Blink Portenta Red Light
    digitalWrite(LEDG,LOW);                                         // Blink Portenta Green Light
    digitalWrite(LEDB,HIGH);                                        // Blink Portenta Blue Light
  }
  
  // Data Saving Loop -------------------------------------------------------------------------------------------------------------------------------------------------------------------
  
  float startTime = millis();
  float loopTime = millis();
  while ( ((millis() - startTime)/1000) <= 20){

  cTime = (millis() - startTime);
  
  if (myICM.dataReady())
    {
      myICM.getAGMT();              // The values are only updated when you call 'getAGMT'
      gyroX = myICM.gyrX();   gyroY = myICM.gyrY();   gyroZ = myICM.gyrZ();
      accX  = myICM.accX();   accY  = myICM.accY();   accZ  = myICM.accZ();
    }

   //X_norm = (X - X_min) / (X_max - X_min)
  
  pcaselect(0);

  current_value_1 = 0;
  current_value_2 = 0;
  current_value_3 = 0;
  current_value_4 = 0;
  
  current_value_1 = mpr1.readPressure();
  //Serial.print(" KPa_1     ");

  pcaselect(1);

  current_value_2 = mpr2.readPressure();
  //Serial.print(" KPa_2     ");

  pcaselect(2);

  current_value_3 = mpr3.readPressure();
  //Serial.print(" KPa_3     ");

  pcaselect(3);
  current_value_4 = mpr4.readPressure();
  //Serial.println(" KPa_4");


  // +++++++++++++++++++++++++++++++++++++++++++++++++++++++++++++++++++++++++++++++++++++++++++++++++++++++++++++++
//  
//  final_value_1 = constrain(current_value_1, offset_value_1, 16777216);    
//  final_value_2 = constrain(current_value_2, baseline_value_2+offset_value_2, 16777216);     
//  final_value_3 = constrain(current_value_3, baseline_value_3+offset_value_3, 16777216);     
//  final_value_4 = constrain(current_value_4, baseline_value_4+offset_value_4, 16777216);      
    
  s1 = constrain(current_value_1 - baseline_value_1, 50000, 16777216);
  s2 = constrain(current_value_2 - baseline_value_2, 50000, 16777216);
  s3 = constrain(current_value_3 - baseline_value_3, 50000, 16777216);
  s4 = constrain(current_value_4 - baseline_value_4, 50000, 16777216);
  
  s = (s1 + s2 + s3 + s4)/4;
//  float s_n = ((s-580000)/(1040937-580000));

//  float accX_n = ((accX + 1858.89)/(2458.98+1858.89));
//  float accY_n = ((accY + 1815.43)/(3999.88+1815.43));
//  float accZ_n = ((accZ + 1763.67)/(3844.24+1763.67));
//  float gyroX_n = ((gyroX + 271.77)/(270.67+271.77));
//  float gyroY_n = ((gyroY + 132.44)/(237.01+132.44));
//  float gyroZ_n = ((gyroZ + 332.20)/(369.09+332.20));
//
//  float s_ax = accX_n * s_n; // Calculate interaction feature s*ax
//  float s_ay = accY_n * s_n; // Calculate interaction feature s*ay
//  float s_az = accZ_n * s_n; // Calculate interaction feature s*az
//  float s_gx = gyroX_n * s_n; // Calculate interaction feature s*gx
//  float s_gy = gyroY_n * s_n; // Calculate interaction feature s*gy
//  float s_gz = gyroZ_n * s_n; // Calculate interaction feature s*gz
  
//  float s_ax = accX_n * s_n; // Calculate interaction feature s*ax
//  float s_ay = accY_n * s_n; // Calculate interaction feature s*ay
//  float s_az = accZ_n * s_n; // Calculate interaction feature s*az
//  float s_gx = gyroX_n * s_n; // Calculate interaction feature s*gx
//  float s_gy = gyroY_n * s_n; // Calculate interaction feature s*gy
//  float s_gz = gyroZ_n * s_n; // Calculate interaction feature s*gz

//  double inputs[] = {s_n, accX_n, accY_n, accZ_n, gyroX_n, gyroY_n, gyroZ_n, s_ax, s_ay, s_az, s_gx, s_gy, s_gz};
//  double output[1];
//  
//  mlp.feedforward(inputs, output);
//  
  Write_SDcard();
  //grf = constrain(output[0], 0.30, 1);
  Serial.print(s1); 
  Serial.print("  "); Serial.print(s2); Serial.print("  "); Serial.print(s3); Serial.print("  "); Serial.print(s4); Serial.print("  "); Serial.println(s);
  //Serial.print("  "); Serial.print(accX, 3); Serial.print("  "); Serial.print(accY, 3); Serial.print("  "); Serial.print(accZ, 3); Serial.print("  "); Serial.print(gyroX, 3); Serial.print("  "); Serial.print(gyroY, 3); Serial.print("  "); Serial.print(gyroZ, 3);  Serial.print("  "); 
  
  
  }
    
    // ----------------------------------------------------------------------------------------------------------------------------------------------------------------------------------
    
    file.close();                                                                               // Closing File in Loop

   // -----------------------------------------------------------------------------------------------------------------------------------------------------------------------------------
   
}


void Write_SDcard()
{
  if (file){
    
    file.print((cTime));                  file.print(",");
    
    file.print((s1));                     file.print(",");
    file.print((s2));                     file.print(",");
    file.print((s3));                     file.print(",");
    file.print((s4));                     file.print(",");
    file.print((s));                      file.print(","); 
    
    file.print((accX));                   file.print(",");
    file.print((accY));                   file.print(","); 
    file.print((accZ));                   file.print(",");
    file.print((gyroX));                  file.print(",");
    file.print((gyroY));                  file.print(",");
    file.print((gyroZ));                  //file.print(",");
    //file.print((grf));

//    file.print((s_ax));                   file.print(","); 
//    file.print((s_ay));                   file.print(","); 
//    file.print((s_az));                   file.print(","); 
//    file.print((s_gx));                   file.print(","); 
//    file.print((s_gy));                   file.print(","); 
//    file.print((s_gz));                            
    
    file.println();                       //End of Row move to next row
    
  }
  
}

void printWiFiStatus() {
  Serial.print("SSID: ");
  Serial.println(WiFi.SSID());
  
  IPAddress ip = WiFi.localIP();
  Serial.print("IP Address: ");
  Serial.println(ip);
}
