Dhruv242003/GRF_Shoe/teensy_codes/DL_integrated/scaling_params.h

#ifndef SCALING_PARAMS_H
#define SCALING_PARAMS_H

const float mean[5] = {801.27125, 763.9757025547445, 753.2615145985401, 760.0018065693431, 56.0};
const float std_dev[5] = {13.501068597457996, 2.019689725356049, 0.6403046476152465, 2.8468605808792486, 1.0};
#endif
