Dhruv242003/GRF_Shoe/teensy_codes/ML_integrated_SVR/scaling_params.h

#ifndef SCALING_PARAMS_H
#define SCALING_PARAMS_H

const float mean[5] = {801.2082461786001, 768.8514883346741, 755.9075221238938, 762.1522365245374, 68.03861625100564};
const float std_dev[5] = {15.118903528603386, 3.2832432686119435, 2.3196898231047163, 5.52571746341488, 4.937432050507664};
#endif
