Dhruv242003/GRF_Shoe/(commit log)

2024-09-18 Hardware complete
    [DATA00.csv, IMU_mount v1.stl, IMU_mount v3.stl, IMU_mount_Cap v1.stl, IMU_mount_Cap v2.stl, Pressure_sensor_case v5.stl, Pressure_sensor_case v9.f3d, Pressure_sensor_case v9.stl]
2024-09-23 data collection started
    [Pressure_sensor_case v13.stl, Side_Cap v2.stl, Side_Cap_2 v2.stl, T1.csv, T1_FP.csv]
2024-10-07 Interpolation done
    [ShoeProcessed.xlsx, Side_Cap v4.stl, T1 - Copy.csv, T2.csv, T2_FP.csv, T2_FP_time.csv, amplified_sensor_data.csv, combinedResult.csv]
2024-10-07 Matlab code completed
    [T2.csv, T2_FP.csv, T2_modified.csv, combinedResult.csv]
2024-10-08 Squats first experiment done
    [combinedResult.csv, squats1Shoe_modified.csv, squats_1_FP.csv, squats_1_Shoe.csv]
2024-10-22 Diwali ki chutti
    [DATA00.csv, Shoe_modified.csv, smart_shoe.pdsprj, squats2_FP.csv, squats2_FPmax.csv, squats2_Shoe.csv, squats2_ShoeMax.csv]
2024-11-11 deep learning started
    [DATA02.csv, DATA06.csv, DATA08.csv, DATA09.csv, Dhruv_FP.csv, Dhruv_Shoe.csv, Prasanna.csv, Shoe_modified.csv]
2024-12-30 Latest changes after new laptop
    [DATA00.csv, Dharmesh_Sit_To_Stand.csv, Dharmesh_sitToStand_FP.csv, Dharmesh_squatting.csv, Dharmesh_squatting_FP.csv, Shoe_modified.csv, aditya.csv, combinedResult.csv]
2025-01-24 IMU test added
2025-02-18 Both shoes code done
    [DATA00-ShoeData.csv, Left_shoe.csv, Pressure_sensor_case v18.stl, Right_shoe.csv, T1-ForcePlateData.csv, combinedResult.csv]
2025-02-28 Two shoes data collected
    [LEFT_DATA00.csv, LEFT_DATA01.csv, LEFT_DATA02.csv, LEFT_DATA03.csv, RIGHT_DATA00.csv, RIGHT_DATA01.csv, RIGHT_DATA02.csv, RIGHT_DATA03.csv]
2025-03-06 Two shoe matlab file completed
    [Left_shoe_processed.csv, Right_shoe_processed.csv, sitting.csv]
2025-03-10 Two subject data collected for two shoe activity new protocol
    [LEFT_DATA00.csv, LEFT_DATA01.csv, LEFT_DATA02.csv, LEFT_DATA03.csv, LEFT_DATA05.csv, Left_shoe_processed.csv, RIGHT_DATA00.csv, RIGHT_DATA01.csv]
2025-03-20 DL working code added
    [Left_shoe_processed.csv, Right_shoe_processed.csv, lean.csv, sitToStand.csv, sitting.csv, squatting.csv, standing.csv]
2025-03-25 Sensor normalization
    [DATA00.csv, LEFT_DATA00.csv, LEFT_DATA01.csv, LEFT_DATA03.csv, LEFT_DATA04.csv, Left_shoe.csv, RIGHT_DATA00.csv, RIGHT_DATA01.csv]
2025-03-26 Arpeet Experiment done
    [LEFT_DATA00.csv, LEFT_DATA01.csv, LEFT_DATA02.csv, LEFT_DATA03.csv, LEFT_DATA04.csv, LEFT_DATA05.csv, Left_shoe_processed.csv, RIGHT_DATA00.csv]
